gligli/p600fw/documentation/pictures/4b_solder_wires.jpg

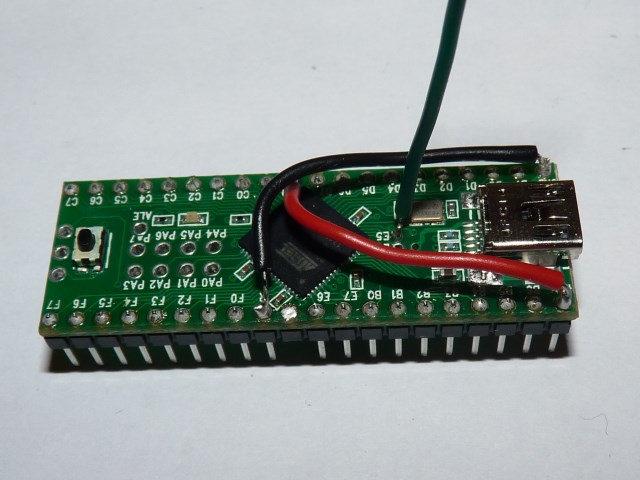
documentation/pictures/4b_solder_wires.jpg
