gligli/p600fw/documentation/pictures/2_solder_wires.jpg

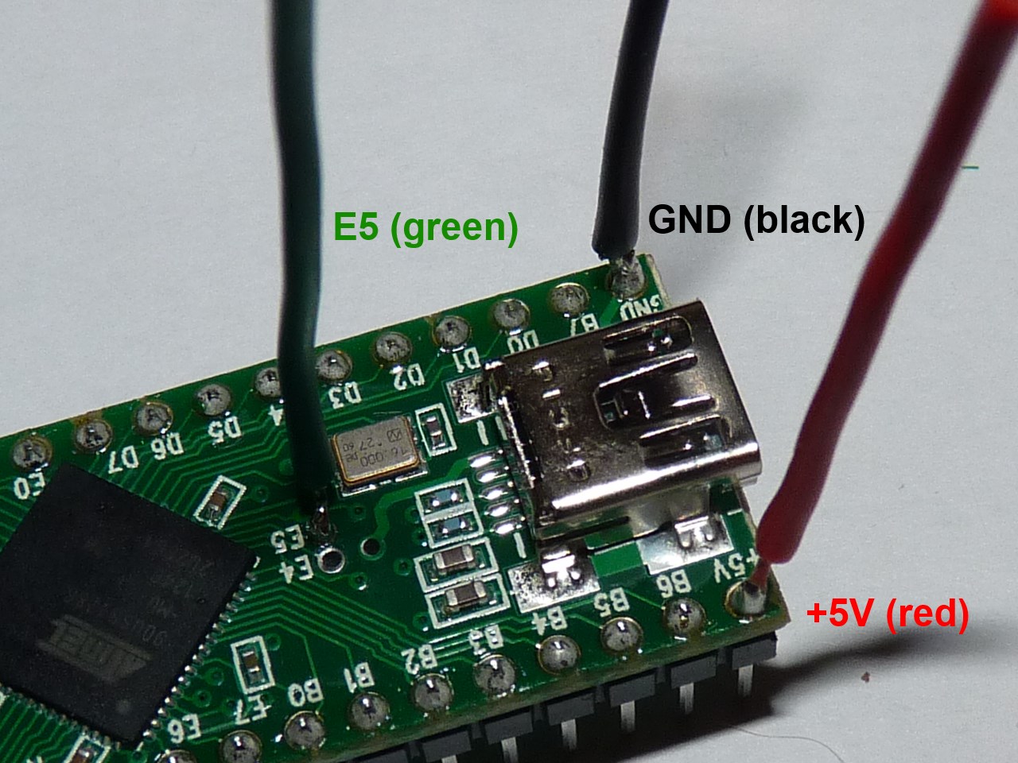
documentation/pictures/2_solder_wires.jpg
