gligli/p600fw/documentation/latex/pitchbend.tex

The Prophet-600 comes with a (pitch) \textbf{Bender} (without automatic return to the middle position). With the upgrade it is possible to customize the range/action and the target of the bender as part of the patch configuration (see below). 

Note: External MIDI pitch bend is \underline{added} to the internal pitch bend\footnote{This is the behaviour of the original firmware. Since the bender does not return to zero a bend override by external MIDI leads to unwanted discontinuous pitch changes when the bender of the Prophet-600 is touched. The addition of both bends is therefore more consistent.}. Full internal and external (MIDI) bend covers twice the range set by the bender range. As a consequence, the external MIDI bend value cannot be reset/overridden using the built in bender, but the external value is reverted to zero during the bender calibration process (see below).

\begin{itemize}
  \item The bender can target the oscillator pitch, the filter cut-off frequency or the amplitude. This is set using the additional patch parameter \bentarget which provides the options \textit{off}, \textit{AB} (bend of the pitch of both oscillators), \textit{VCF} (modulating the cut-off frequency), \textit{volume} (modulating the amplitude) and \textit{b} (bending the pitch of oscillator B only).
  \item The range of the bender can be configured using the additional patch parameter \bendrange. It offers the choices \textit{2nd} (bend a full tone), \textit{3rd} (bend 4 semi-tones), \textit{5th} (bend 7 semi-tones) and \textit{octave} (bending an entire octave).
\end{itemize}

The upgraded Prophet-600 also offers the option to calibrate the bender middle position using one of the miscellaneous settings/function (see section \ref{settingsref}). This function is useful to remove jittery behaviour of the bender around the middle position. In order to calibrate the bender follow the steps below.

\begin{enumerate}
  \item Move the bender to the middle position.  
  \item Activate bender calibration by pressing \numberbut{3} in \shiftmode or \shiftlock (the display will show that the bender calibration mode is active). Pressing \numberbut{3} again applies and confirms the calibration and exits the calibration mode.
\end{enumerate}

As mentioned above, the current active external (MIDI) bend value is set to zero during the calibration process. To be precise, it is set to zero with the first press of \numberbut{3} in \shiftmode or \shiftlock.
