gligli/p600fw/documentation/latex/envelopes.tex

Like the original version, the upgraded Prophet-600 offers two ADSR envelopes. The first one is the filter envelope, which modulates the filter cut-off frequency. Its parameters are located in the filter section of the panel, see section \ref{filter}. The second envelope has a dedicated sub-panel below the filter section\footnote{In the original Prophet-600 as well as in the upgrade up to version 2.1 RC3 the 2nd envelope is a dedicated amplitude envelope and on the original panel and on the existing panel overlays the sub-panel is marked "Amplifier". With the envelope routing option in the latest firmware version the envelope and its sub-panel are more appropriately called "2nd Envelope" in this document.}.

Both envelopes work identically in that they have a classic ADSR setup with an \attack control, a \decay control, a \sustain control and a \release control. 

\begin{center}
\scalebox{0.4}{
  \begin{tikzpicture}[scale=0.8]

    \addpar{-18cm,3.5cm}{\secndenv \\ This modifies the overall shape and speed range of the second envelope. It influences the attack, decay and release phases of the envelope};
    \draw[line width = 2pt, dashed] (-4cm,3.5cm) -- (1cm,3.5cm);

      \adsrpanel{0,0}
  \end{tikzpicture}
}
\end{center}

The upgraded Prophet 600 provides faster and smoother envelopes, with two different envelope time scales (\textit{slow} and \textit{fast}) and two envelope shapes (\textit{linear} and \textit{exponential})

You can set the shape and speed range independently for the filter and the 2nd envelope using two additional patch parameters. The parameter \secndenv changes the 2nd envelope and the parameter \filenv changes the filter envelope. Each of the two parameters can take the following values:

\begin{itemize}
  \setlength\itemsep{0cm}
  \item \textit{linear - slow}
  \item \textit{exponential - slow}
  \item \textit{linear - fast}
  \item \textit{exponential - fast}
\end{itemize}
 
 The envelope shapes are shown below. The \textit{linear} shape is strictly linear in the entire attack phase and in the main attenuation phases of decay and release, but it tails out exponentially. \footnote{Up to version 2.1 RC3 the linear envelope shape was strictly linear in the decay and release without a soft tail. The new shape sounds more organic as it does not drop hard to zero. It was inspired by the Prophet-5 rev 1/2 envelope behaviour.} 
 
 \scalebox{0.6}{
  \begin{tikzpicture}[scale=0.8]
    \envelopeexp{0,0}{6}{4}{5}{8}{6}

\end{tikzpicture}
  }

The phase durations of the ADSR envelopes range between $<30 ms$ to $>50 s$.

\textbf{Envelope modulation targets}
 
The envelopes have three available targets: filter cut-off frequency, amplitude and poly-mod (for this see section \ref{polymod}). The filter envelope is always routed to the filter cut-off frequency and the modulation strength is controlled by the \filenv control. For the  amplitude and poly-mod targets, different routing options are provided as described in detail in the section on poly-mod \ref{polymod}. The additional patch parameter \envrouting is used to configure which envelope modulates which target. The main benefit from the routing options is to make poly-mod independent from the filter dynamics. The default routing is that the poly-mod is modulated by the filter envelope and the amplitude is modulated by the 2nd envelope. This is the original routing and the routing of versions 2.0 and 2.1 RC3. 

The modulation strength of the amplitude is fixed and positive in the Prophet-600. The modulation strength of the poly-mod is set by the bipolar \polymodenv control as explained in section \ref{polymod}.
