gligli/p600fw/documentation/latex/patchref.tex

\footnotesize
\renewcommand{\arraystretch}{1.3}
\begin{tabular}{ p{1.5cm}|p{3cm}|p{5cm}|p{5cm}|p{4cm}} 
   Number & Group & \makebox{1st press} & \makebox{2nd press} & \makebox{3rd press}\\ \hline
  0 & Speed & \makebox{Seq/Arp Speed} \linebreak \textit{numeric 0...99} & &  \\ \hline
  1 & LFO & \makebox{LFO Shape} \linebreak \textit{tri-pulse, sin-random, saw-noise} & \makebox{LFO Target} \linebreak \textit{A\&B, A, B, A \& B \& VCA } &  \makebox{LFO Clock Sync} \linebreak \textit{off, key, 1, 2, 3, 4, 5, 6, 8} \\ \hline
  2 & \makebox{Vibrato} & \makebox{Vibrato Speed} \linebreak \textit{numeric 0...99} & \makebox{Vibrato Amount} \linebreak \textit{numeric 0...99} & \makebox{Vibrato Target} \linebreak \textit{VCO, VCA, VCO A, VCO B} \\   \hline
  3 & \makebox{Modulation Wheel} & \makebox{Modulation Wheeel Target} \linebreak \textit{LFO, vibrato} & \makebox{Modulation Delay} \linebreak \textit{numeric 0...99} & \makebox{Moduation Wheel Range} \linebreak \textit{touch, soft, high, full} \\ \hline
  4 & \makebox{Configuration} & \makebox{OSC Pitch Mode} \linebreak \textit{free, semi-tones, octaves} & \makebox{External Voltage} \linebreak \textit{numeric 0...99} & \makebox{Pulse Reset Bug} \linebreak \textit{on, off} \\ \hline
  5 & Envelope & \makebox{Filter Envelope Shape} \linebreak \textit{lin-slow, lin-fast, lin-slo, exp-fast}  & \makebox{2nd Envelope Shape} \linebreak \textit{fast-lin, fast-exp, slo-lin, slo-exp} &
  \makebox{Envelope Routing} \linebreak \textit{std, poly-amp, poly, gate}\\ \hline
  6 & Bender & \makebox{Bender Target} \linebreak \textit{off, AB, VCO, VCF, vol, B} & \makebox{Bend Range}  \linebreak \textit{2nd, 3rd, 5th, octave} &  \\ \hline
  7 & \makebox{Play Mode} & \makebox{Note Priority} \linebreak \textit{last, low, high} & \makebox{Voice Assigner} \linebreak \textit{first, cycle} & Glide\textsuperscript{*)} \linebreak \textit{numeric 0...99}  \\ \hline
  8 & \makebox{Oscillator} & Detune \linebreak \textit{numeric 0...99}  &   \makebox{Vintage (Spread)} \linebreak \textit{numeric 0...99} & Drive\textsuperscript{*)} \linebreak \textit{numeric 0...99} \\ \hline
  9 & \makebox{Touch Sensitivity} & \makebox{Amplitude Velocity} \linebreak \textit{numeric 0...99}  & \makebox{Filter Velocity} \linebreak \textit{numeric 0...99} &  \\
  
\end{tabular}

\normalsize

\textsuperscript{*)} The availability of parameters \glide and \drive depend on the panel layout. In \textit{GliGli} panel layout \glide is available and drive is obsolete. In \textit{SCI} layout the parameter \drive is available while the glide parameter is set using the dedicated dial on the panel.
