gligli/p600fw/documentation/latex/filter.tex

The mix of the two VCOs is routed through a resonant 24db low pass filter (built on a Curtis CEM3372 filter). The control for the filter consists of a \filtercutoff dial regulating the cut-off frequency, and a \filterres dial for the resonance. The \filterenv dial regulates how strongly the cut-off frequency is modulated by the filter envelope. This dial is bipolar. It supports positive and negatives values (effectively an inverse envelope setting). The display will show values between -50 and 50 depending on position. This is major enhancement compared to the original Prophet-600 firmware which  featured only positive values.

\begin{center}
\scalebox{0.4}{
  \begin{tikzpicture}[scale=0.8]
    \addpar{-18cm,9.8cm}{\textbf{Filter Limit} \\ Using the miscellaneous setting options the cut-off frequency can be limited to 22kHz, see section \ref{limitsett} for details.};
    \draw[line width = 2pt, dashed] (-4cm,9.3cm) -- (1cm,9.3cm);

    \addpar{-18cm,2cm}{\textbf{\filenv} \\ This modifies the overall shape and speed range of the envelope. It influences the attack, decay and release phases, see \ref{envelopes} for details};
    \draw[line width = 2pt, dashed] (-4cm,3.5cm) -- (1cm,3.5cm);

    \filterpanel{0,0}
  \end{tikzpicture}
}
\end{center}

The \keyboardtrack switch has the setting \textit{Off}, \textit{1/2} and \textit{Full}. It lifts the cut-off frequency depending on keyboard note, i.e. the cut-off frequency is higher for higher notes. The effect applies to the cut-off frequency resulting from the fixed \filtercutoff setting plus any envelope and LFO modulation.  

\textbf{Equal tempered tuning of the filter cut-off frequency}

In the Prophet-600 the filter cut-off frequency is tuned in the same manner as the oscillator frequencies. Furthermore \keyboardtrack is implemented in a way to allow equal tempered play using the filter:

\begin{itemize}
  \item When \keyboardtrack is set to \textit{half} then the filter cut-off is increased by a semitone every two semitones on the keyboard 
  \item When \keyboardtrack is set to \textit{full} then the filter cut-off is increased by a semitone with every semitone on the keyboard, i.e. if follows the scale 
\end{itemize}

This feature essentially provides a third oscillator per voice. You can play harmonically using the filter at self-resonance even without oscillator A or B active - you should set the \filterenv dial to zero, at least in first experiments. The \filtercutoff acts as a tuning dial in this case. You can also use the self-resonant filter in combination with oscillators A and B if you "tune" the filter frequency appropriately. You can even use cross-modulation using the poly-mod function to modulate the filter cut-off using oscillator B (see section \ref{polymod}). However, there is no way to control the volume of the filter self-resonance relative to the volume of oscillators A and B.
