gligli/p600fw/documentation/latex/defaultpatch.tex

When powered up, the Prophet-600 starts either in \presetmode (with the last selected patch loaded) or in \livemode. In either mode the user can load a default setup to start a new patch. To load the default patch press the \preset button twice in \shiftmode or \shiftlock (upon first press the display shows that another press will load the default patch). When the default patch is loaded, the Prophet-600 automatically switches to \presetpanel. Note that loading  the default patch overwrites the patch menu parameters and therefore any unsaved patch parameter values in \presetmode are lost.

The default patch is intended to be a very basic/minimal setup. The values are shown in the table below.

\footnotesize
\renewcommand{\arraystretch}{1.3}

\begin{longtable}[l]{p{5cm}|p{5cm}|p{5cm}|p{5cm}|} 
\textbf{Continuous Parameter} & \textbf{Value} & \textbf{Stepped Parameter} & \textbf{Value} \\ \hline
\endfirsthead
\textbf{Continuous Parameter} & \textbf{Value} & \textbf{Stepped Parameter} & \textbf{Value} \\ \hline
\endhead 
Osc A Frequency & \textit{c0} & Osc A Saw & \textit{on} \\ \hline
Osc A Volume & \textit{full} & Osc A Triangle &\textit{off} \\ \hline
Osc A Pulse Width & \textit{half} & Osc A Square & \textit{off} \\ \hline
Osc B Frequency & \textit{c0} & Osc B Saw & \textit{off} \\ \hline
Osc B Volume & \textit{zero} & Osc B Triangle & \textit{off} \\ \hline
Osc B Pulse Width & \textit{half} & Osc B Sqr &\textit{off} \\ \hline
Osc B Fine & \textit{zero} & Sync & \textit{off} \\ \hline
Cutoff & \textit{full} & Poly Mod Oscillator A Destination & \textit{off} \\ \hline
Resonance & \textit{zero} & Poly Mod Filter Destination & \textit{off} \\ \hline
Filter Envelope Amount & \textit{zero} & LFO Shape & \textit{triangle-pulse} \\ \hline
Filter Release & \textit{zero} & LFO Sync & \textit{off} \\ \hline
Filter Sustain & \textit{zero} & LFO Targets & \textit{A \& B} \\ \hline
Filter Decay & \textit{zero} & Keyboard Filter Tracking & \textit{off} \\ \hline
Filter Attack & \textit{zero} & Filter Envelope Shape & \textit{linear} \\ \hline
Amp Release & \textit{zero} & Filter Envelope Fast/Slow & \textit{slow} \\ \hline
Amp Sustain & \textit{full} & 2nd Envelope Shape & \textit{linear} \\ \hline
Amp Decay & \textit{zero} & Unison & \textit{off} \\ \hline
Amp Attack & \textit{zero} & Assigner Priority Mode & \textit{last} \\ \hline
Poly Mod Filter Amount & \textit{zero} & Bender Range (semitones) & \textit{5 semitones} \\ \hline
Poly Mod Osc B Amount & \textit{zero} & Bender Target & \textit{pitch A \& B} \\ \hline
LFO Frequency & \textit{mid} & Mod Wheel Range & \textit{soft} \\ \hline
LFO Amount & \textit{zero} & Osc pitch mode & \textit{octave-octave} \\ \hline
Glide & \textit{zero} & Mod Wheel Target & \textit{LFO} \\ \hline
Amp Velocity & \textit{mid} & Vibrato Target & \textit{pitch} \\ \hline
Filter Velocity & \textit{zero} & 2nd Envelope Fast/Slow & \textit{slow} \\ \hline
Modulation delay & \textit{zero} & Sync Bug & \textit{off} \\ \hline
Vibrato frequency & \textit{mid} & Voice Assign & \textit{first} \\ \hline
Vibrato amount & \textit{zero} & Envelope Routing & \textit{standard} \\ \hline
Unison detune & \textit{zero} & &  \\ \hline
External CV amount & \textit{zero} &  &  \\ \hline
Vintage / Spread & \textit{zero} &  &  \\ \hline 
\end{longtable}
