gligli/p600fw/documentation/latex/settingsref.tex

\footnotesize
\renewcommand{\arraystretch}{1.6}
\begin{tabular}{ p{2cm}|p{4cm}|p{6cm}|p{6cm}} 
   \textbf{Number} & \textbf{Purpose} & \makebox{\textbf{1st press}} & \makebox{\textbf{Repeated press}} \\
 \hline
  0 & \makebox{MIDI mode} & \makebox{Show current selected voice status} & \makebox{Toggle MIDI mode} \linebreak \textit{local on, local off}  \\
 \hline
  1 & \makebox{MIDI Receive} & \makebox{Show current MIDI receive channel} & \makebox{Cycle through channels} \linebreak \textit{OMNI, Ch1 ... Ch16} \\
 \hline
  2 & \makebox{MIDI Send} & \makebox{Show current MIDI send channel} & \makebox{Cycle through channels} \linebreak \textit{Ch1 ... Ch16} \\
 \hline
  3 & \makebox{Bender Calibration} & \makebox{Activate calibration mode} & \makebox{Confirmation} \\
 \hline
  4 & \makebox{Voice Selection} & \makebox{Show current selected voice} & \makebox{Cycle through voices} \linebreak \textit{1 ... 6} \\
 \hline
  5 & \makebox{Voice Deactivate} & \makebox{Show current selected voice status} & \makebox{Toggle voice status} \linebreak \textit{on, off} \\
 \hline
  6 & \makebox{Panel Layout} & \makebox{Show current selected panel layout} & \makebox{Toggle panel layout} \linebreak \textit{GliGli, SCI} \\
 \hline
  7 & \makebox{Unused} & & \\
 \hline
  8 & \makebox{Clock Sync} & \makebox{Show current clock sync} & \makebox{Cycle through sync types} \linebreak \textit{internal, MIDI, tape}  \\
 \hline
  9 & \makebox{VCF limit} & \makebox{Show current setting} & \makebox{Cycle through settings} \linebreak \textit{on, off}  \\
 \hline
  Preset & \makebox{Default Patch} & \makebox{Activate default patch load} & \makebox{Confirmation} \\
 \hline
  Tune & \makebox{Per Note Tuning} & \makebox{Activate per note tuning} & \makebox{Deactivate/save per note tuning} \\
 \hline
  Record & \makebox{MIDI Patch Receive Mode} & \makebox{Activate MIDI patch receive mode} & \makebox{End MIDI patch receive mode} \\
  \end{tabular}
\normalsize
