gligli/p600fw/documentation/latex/p600fw_Cheat_Sheet.tex

\documentclass{report}
\usepackage{lmodern}
\usepackage{hyperref}
\usepackage{titlesec}
\usepackage{scrextend}
\usepackage{array}
\usepackage{ProphetPanel}
\usepackage{fontspec}
\usepackage[T1]{fontenc}
\usepackage{float}
\usepackage[paperheight=7.1cm,paperwidth=6.1cm,margin=5pt,heightrounded]{geometry}

\begin{document}

  \scalebox{0.7}{
    \begin{tikzpicture}[scale=0.8]
      \numberpadcc{-10cm,0cm}
    \end{tikzpicture}
  }

\end{document}
