gligli/p600fw/documentation/pictures/1_cut_5v.jpg

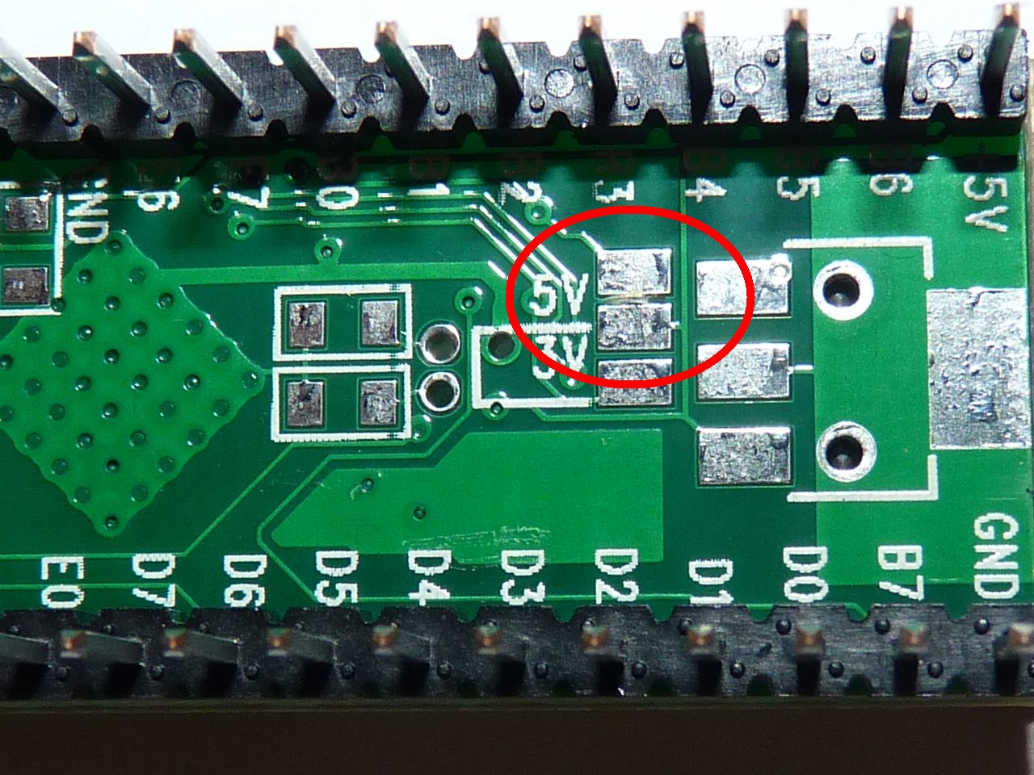
documentation/pictures/1_cut_5v.jpg
