gligli/p600fw/documentation/pictures/3_cut_pin.jpg

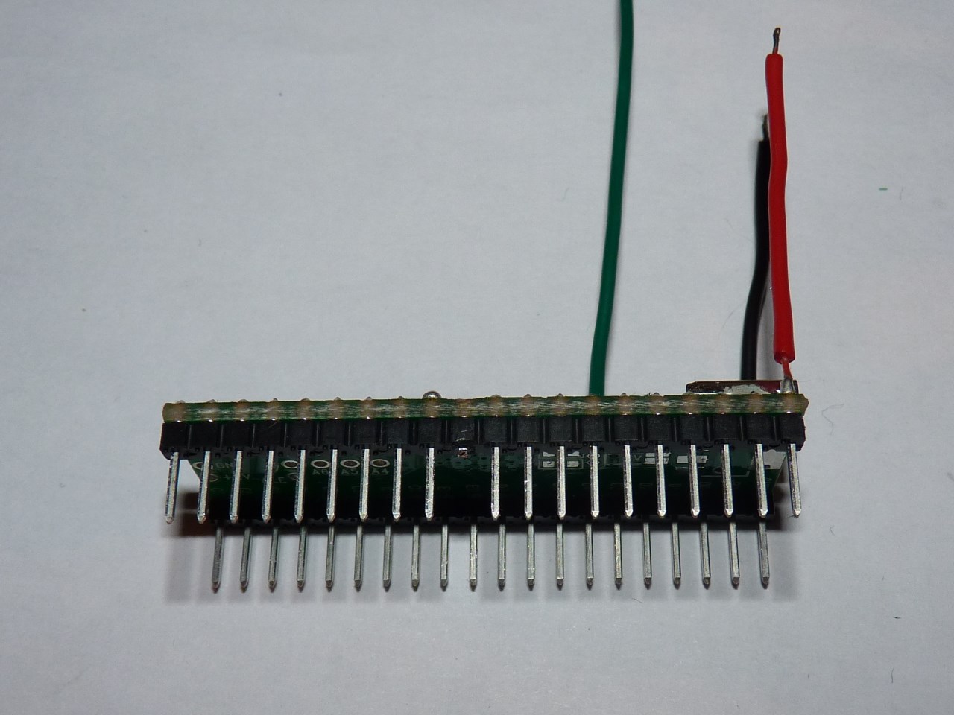
documentation/pictures/3_cut_pin.jpg
