gligli/p600fw/documentation/pictures/5_plug_wire.jpg

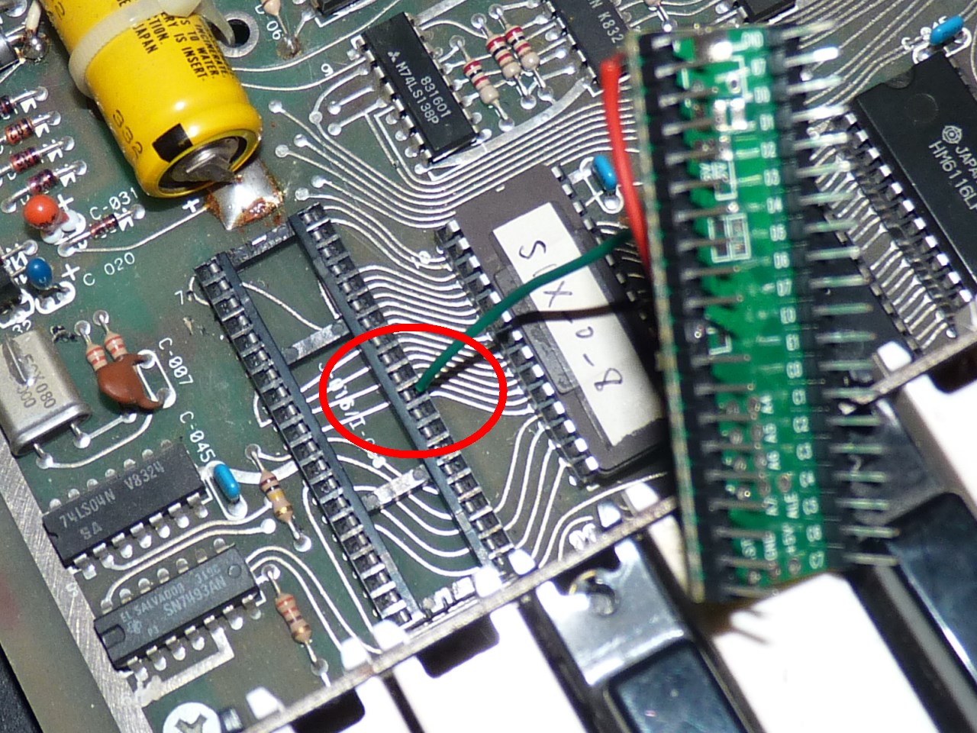
documentation/pictures/5_plug_wire.jpg
