gligli/p600fw/documentation/pictures/6_plug_teensy.jpg

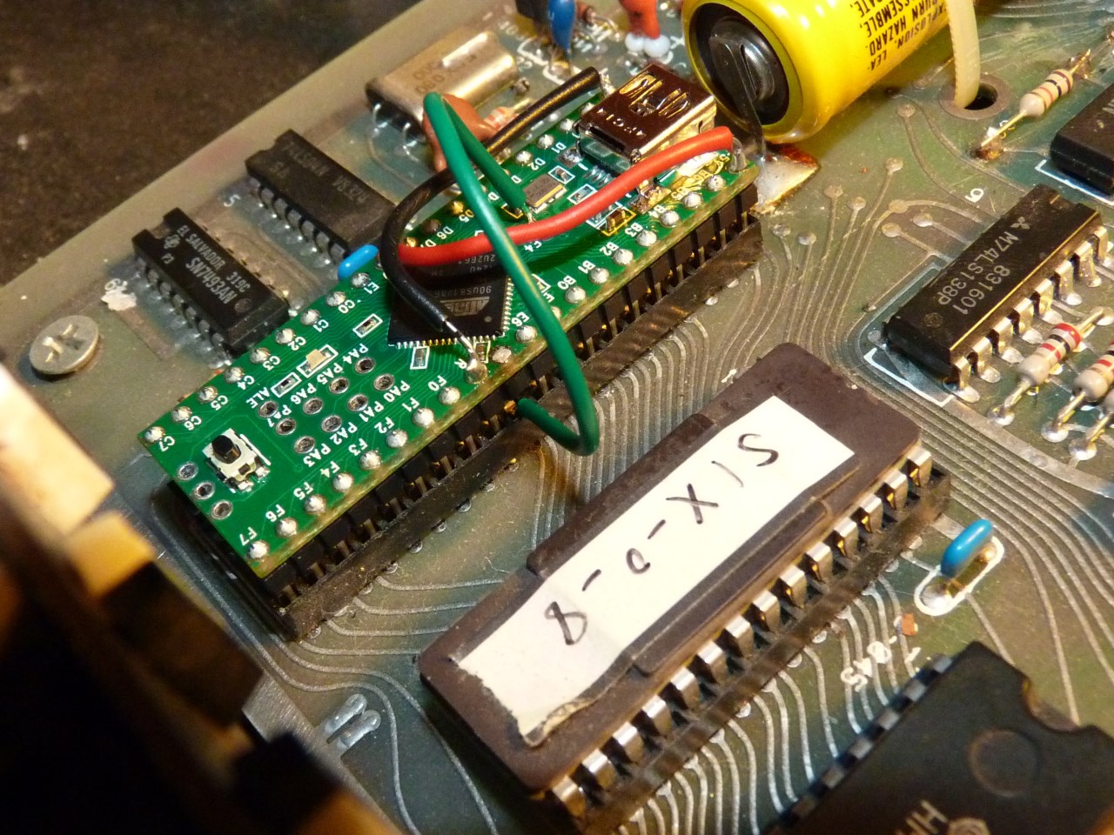
documentation/pictures/6_plug_teensy.jpg
