gligli/p600fw/documentation/pictures/external_24LC512_EEPROM/20251117_125559.jpg

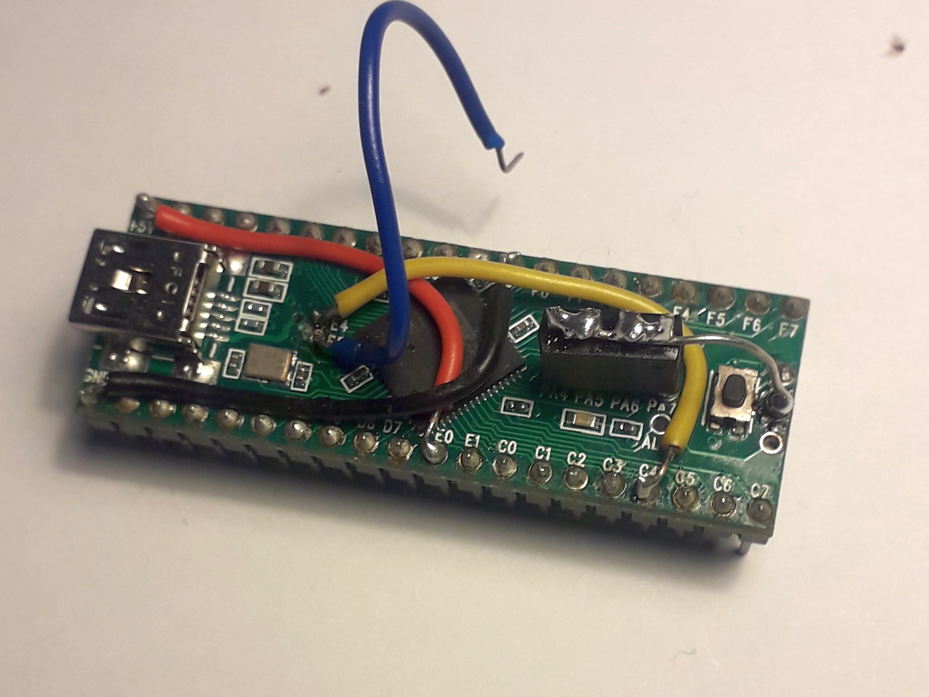
documentation/pictures/external_24LC512_EEPROM/20251117_125559.jpg
