gligli/p600fw/documentation/sysex_format.ods

Overall SYSEX patch dump request format
Bit count | Value | Description
8 | 0xF0 | SYSEX header
24 | 0x00 0x61 0x16 | My vendor identifier
8 | 0x02 | Command code, “Patch dump request” here
8 | 0-99 | Patch number
8 | 0xF7 | SYSEX footer
Overall SYSEX patch dump format
Bit count | Value | Description
8 | 0xF0 | SYSEX header
24 | 0x00 0x61 0x16 | My vendor identifier
8 | 0x01 | Command code, “Patch dump” here
variable | variable | Encoded raw patch data, truncated to the last nonzero byte
8 | 0xF7 | SYSEX footer
Encoded data format (repeats every 32 bits of raw data)
Bit count | Value | Description
1 | 0 | Padding
7 | variable | Bits 30-24 of raw data (MSB first)
1 | 0 | Padding
7 | variable | Bits 22-16 of raw data (MSB first)
1 | 0 | Padding
7 | variable | Bits 14-8 of raw data (MSB first)
1 | 0 | Padding
7 | variable | Bits 6-0 of raw data (MSB first)
4 | 0 | Padding
1 | variable | Bit 7 of raw data
1 | variable | Bit 15 of raw data
1 | variable | Bit 23 of raw data
1 | variable | Bit 31 of raw data
Raw patch data format
Bit count | Value | Description
8 | 0-99 | Patch number
32 | 0xA5 0x16 0x61 0x00 | My patch format identifier
8 | 0x02 | My patch format version
16 | unsigned, little endian order | Osc A Frequency
16 | unsigned, little endian order | Osc A Volume
16 | unsigned, little endian order | Osc A Pulse Width
16 | unsigned, little endian order | Osc B Frequency
16 | unsigned, little endian order | Osc B Volume
16 | unsigned, little endian order | Osc B Pulse Width
16 | unsigned, centered on half scale, little endian order | Osc B Fine
16 | unsigned, little endian order | Cutoff
16 | unsigned, little endian order | Resonance
16 | unsigned, centered on half scale, little endian order | Filter Envelope Amount
16 | unsigned, little endian order | Filter Release
16 | unsigned, little endian order | Filter Sustain
16 | unsigned, little endian order | Filter Decay
16 | unsigned, little endian order | Filter Attack
16 | unsigned, little endian order | Amp Release
16 | unsigned, little endian order | Amp Sustain
16 | unsigned, little endian order | Amp Decay
16 | unsigned, little endian order | Amp Attack
16 | unsigned, centered on half scale, little endian order | Poly Mod Filter Amount
16 | unsigned, little endian order | Poly Mod Osc B Amount
16 | unsigned, little endian order | LFO Frequency
16 | unsigned, little endian order | LFO Amount
16 | unsigned, little endian order | Glide
16 | unsigned, little endian order | Amp Velocity
16 | unsigned, little endian order | Filter Velocity
7 | 0 | Padding
1 | bit (Off=0,On=1) | Osc A Saw
7 | 0 | Padding
1 | bit | Osc A Triangle
7 | 0 | Padding
1 | bit | Osc A Square
7 | 0 | Padding
1 | bit | Osc B Saw
7 | 0 | Padding
1 | bit | Osc B Triangle
7 | 0 | Padding
1 | bit | Osc B Sqr
7 | 0 | Padding
1 | bit | Sync
7 | 0 | Padding
1 | bit | Poly Mod Oscillator A Destination
7 | 0 | Padding
1 | bit | Poly Mod Filter Destination
5 | 0 | Padding
3 | Pulse=0,Tri=1,Rand=2,Sine=3,Noise=4,Saw=5 | LFO Shape
7 | 0 | Padding
1 | Low=0,High=1 | LFO Speed Range
2 | 0 | Padding
6 | None=0,VCO=1,VCF=2,VCA=4,PW=8,OnlyA=16,OnlyB=32 (combination of those) | LFO Mode Destination
6 | 0 | Padding
2 | None=0,Half=1,Full=2 | Keyboard Filter Tracking
7 | 0 | Padding
1 | Linear=0,Exponential=1 | Filter EG Exponential/Linear
7 | 0 | Padding
1 | Fast=0,Slow=1 | Filter EG Fast/Slow
7 | 0 | Padding
1 | Linear=0,Exponential=1 | Amp EG Exponential/Linear
7 | 0 | Padding
1 | Fast=0,Slow=1 | Amp EG Fast/Slow
7 | 0 | Padding
1 | bit | Unison
6 | 0 | Padding
2 | Last=0,Low=1,High=2 | Assigner Priority Mode
4 | 0 | Padding
4 | 2nd=2,3rd=5,5th=7,Octave=12 | Pitch bender semitones
6 | 0 | Padding
2 | Off=0,VCO=1,VCF=2,Volume=3 | Pitch bender target
5 | 0 | Padding
3 | Min=5,Low=3,High=1,Full=0 | Modulation wheel range
6 | 0 | Padding
2 | Free=0,Semitone=1,Octave=2 | Osc pitch mode
16 | unsigned, little endian order | Modulation delay
16 | unsigned, little endian order | Vibrato frequency
16 | unsigned, little endian order | Vibrato amount
16 | unsigned, little endian order | Unison detune
16 | unsigned, little endian order | Arpeggiator/sequencer clock
7 | 0 | Padding
1 | LFO=0,Vibrato=1 | Modulation wheel target
8 | 0 | Padding
6*8 | 6 offsets in semitones to the lowest chord note, 0xFF padded. Eg: 6 times 0x00 for unison, 0x00 plus 5 times 0xFF for mono mode. | Unison track pattern
