gligli/p600fw/documentation/Prophet600_User_Manual.odt

GliGli’s Sequential Circuits Prophet 600 Firmware Upgrade

Table of Contents

###### User Manual / Getting Around the New Prophet 600

###### Review of New Features

The Prophet 600 Firmware Upgrade hosts the following improvements:

1. Easy-to-install non-destructive firmware drop-in replacement of the new firmware. If you ever find yourself pining for the old sound of your Prophet 600, you can remove the Teensy and restore the Z80.
2. Greater resolution of many of the sound parameters with an improved refresh rate that is making the instrument much more responsive.
3. Faster, smoother amplifier and filter envelope generators supporting four different modes:
  1. Fast Linear.
  2. Slow Linear.
  3. Fast Exponential.
  4. Slow Exponential.
4. A new LFO function generator with a wider range from one cycle every <20 seconds> to about 60Hz with four new waveforms in addition to the original triangle and square including sine, random stepped, noise (like on the original Prophet 5, but non-periodic) and sawtooth (ramp up).
5. A dedicated vibrato which can be controlled by the modulation wheel, or can start progressively after a fixed amount of time.
6. Multiple keyboard modes including last/low/high note priority.
7. Unison detune.
8. Mix Overdrive which now allows the output from both oscillators to drive the mix VCAs A and B harder as well as the Curtis 4 pole filter resulting in new sonic possibilities.
9. Pitch Wheel interval selection of plus/minus one octave, a whole tone, a minor third and a fifth.
10. Pitch Wheel reassignment to the VCF and Volume or off.
11. Modulation wheel intensity setting from Maximum to Medium to Minimum.
12. Full Midi In control including:
  1. Amp and Filter velocity sensitivity with an external keyboard controller.
  2. Continuous Controllers (CC) of all sound parameters.
  3. Program change (PC) to choose current preset.
  4. Synchronizing the arpeggiator to MIDI clock.
13. A new and improved tuning procedure.
14. Octave, chromatic and free Oscillator course pitch control.
15. Plus/Minus setting for Oscillator Fine Tune and Filter Envelope amount for Poly Mod and Filter.
16. Assignable, Random And Up/Down Arpeggiator.
17. Debounce feature that prevents unintended retriggering caused by the old keyboard.
18. Organised open source code available on GitHub: https (https://github.com/gligli/p600fw):// (https://github.com/gligli/p600fw)github (https://github.com/gligli/p600fw). (https://github.com/gligli/p600fw)com (https://github.com/gligli/p600fw)/ (https://github.com/gligli/p600fw)gligli (https://github.com/gligli/p600fw)/ (https://github.com/gligli/p600fw)p (https://github.com/gligli/p600fw)600 (https://github.com/gligli/p600fw)fw (https://github.com/gligli/p600fw)

###### Settings Pages

The Prophet 600 is now organised around two menu pages through which you configure the instrument.

1. The Additional Parameters Page is the default page in manual mode, and is active when pressing “to tape” in preset mode: This is the normal interaction page. The advanced sound parameters are found here such as selecting new LFO waveforms, envelope generator profiles and ranges of various controllers.
2. A Miscellaneous Settings Page active when “from tape” is kept pressed: This is the page used to access various “housekeeping” parameters such as setting MIDI channels and modes and so on.

###### Tune

Upon first power-up, the Prophet 600 tunes itself. The “Tune” light illuminates and the display indicates the oscillator or filter being tuned from A1 through A6, b1 through b6 and F1 through F6 for Oscillator A, B and the Filter respectively. The routine takes about 20 seconds to complete depending on the tuning of your instrument.

It is normal to have to retune the instrument during the first 30 minutes of operation as the electronics warm to a stable operating temperature. To tune, simply press the tuning button as required.

###### Manual/Preset Modes

As with the original Prophet 600 firmware, pressing the Preset button switches between manual mode, in which the synthesiser parameters sound parameters reflect the active sonic-state of the instrument, and preset mode in which the sound is a stored patch.

You can edit a stored patch or manual patch or preset patch at any time by completing the following:

1. Press the “Record” button on the keypad. It will blink.
2. Press the two digit location to which you want to save the patch.

The patch is saved. It will overwrite whatever sound patch was there before.

You can cancel a patch store any time while the “Record” button is blinking by pressing record.

###### Additional Parameters Page Quick Guide

Below is a table summarising the Parameters and keypad buttons required to access the synthesiser additional parameters. More detailed instructions are provided after the table summary.

To select a parameter, press one of the keypad numbers once or twice, its name and value will be displayed. To edit it, used the “Speed” knob.

###### Miscellaneous Settings Page Quick Guide

Below is a table summarising the keypad buttons required to access the synthesiser miscellaneous settings. More detailed instructions are provided after the table summary.

To access a function, maintain “from tape” pressed and press a keypad number.

###### Arpeggiator

The instrument supports three arpeggiator modes:

1. Arp Down/Up plays an up/down note sequence with double trigger on the lowest and highest note. For example, playing C3 C4 E4 G4 will play: C3 C4 E4 G4 G4 E4 C4 C3 C3 C4 and so on. Mathematically, it allows you to work out the time signature. Three notes results in ¾ time, notes 4/4 time, 5 notes in 5/4, etc. To play with the Arp Up/Down, press the Arp Dn/Up button on the keypad. The “Arp Dn/Up” will light continuously.
2. Arp Assignable sequences the notes in the order that they are played. To play with the Arp Assignable, press the “Arp Assign” button and play the notes in the order you want them sequenced. The “Arp Assign” will light continuously.
3. Arp Random plays notes played in a random order. To play the Arp Random, press the “Arp Assign” button twice until it blinks and then play the notes.

With all Arpeggiator modes, press the “Record” button on the keypad to latch or hold the notes played. Playing additional notes while in Record mode will latch addition notes to the existing sequence to a maximum of 128 notes. To clear the notes from the sequence, press the “Record” button to switch it off.

The speed is controlled by pressing “0” once on the additional parameters page and using the “Speed” knob to change it.

The foot switch input can be used to hold the arpeggiator.

###### Keyboard Modes

The Prophet 600 can be either in Polyphonic, Unison or Chord mode.

1. The synthesizer starts in Polyphonic mode, in which any new note will be assigned to one of the 6 voices.
2. If you switch “Unison track” on with no pressed key, you are in Unison mode, all 6 voices will play the same note.
3. If you switch “Unison track” on with one or more pressed keys, you are in Chord mode. The pattern those keys made will now be transposed over the whole keyboard range by new notes.

The foot switch input can be used to latch a new pattern of notes.

New notes will be assigned to voices using one of those priority rules:

1. “Last”: New notes will always play, the oldest notes may be stolen.
2. “Low”: Only the lowest notes will play. In Unison or Chord mode, legato will be active.
3. “High”: Only the highest notes will play. In Unison or Chord mode, legato will be active.

The assignment priority is controlled by pressing “7” twice on the additional parameters page and using the “Speed” knob to change it.

###### New Behaviour for Knobs

###### Value Display

When you turn any knob, its value will now be shown on the 7-segment display.

That value will always go from 0 to 255. The display being only 2 digits, the decimal dot is used to show hundreds (no dot for 0-99, steady dot for 100-199, blinking dot for 200-255).

The knob true resolution can be greater than 0-255 (8bits) to ensure smooth sound changes.

###### Oscillator A and B Mix

A new feature has been introduced that allows the VCAs into the filter to be over-driven by Oscillator A and B. In order to support this, the Oscillator A/B Mix has been reassigned to the Oscillator A Level and the Glide knob now controls the Oscillator B Level. The normalised point is at about half way or 5 on the dial. To overdrive the inputs, go all the way to 10. Because of this, the Glide speed has been reassigned to the “Glide” additional parameter (press “7” once on the additional parameters page).

Negative Values

The Poly Mod Filter Amount, the Filter Amount and the Detune knobs are now zero set to the midway position to allow both positive and negative values. This means that inverse envelopes can be applied to the modulations and filter controls and it is now possible to detune Oscillator B flat as well as sharp with respect to Oscillator A.

###### Low Frequency Oscillator

###### LFO Waveform

The Prophet 600 now supports six waveforms in addition to the standard Triangle and Square waves including Sine, (Saw) Ramp Up, Random, Noise. To select the desired waveform:

1. For Triangle, Sine or Saw:
  1. If you are in preset mode, make sure “to tape” is lit, else press it to access the additional parameters page.
  2. Switch the LFO-MOD Shape button to Triangle.
  3. Press the “1” button once and use the “Speed” knob to select the Triangle, Sine or Saw. The display indicates the current selection.
1. For Square, Random or Noise:
  1. If you are in preset mode, make sure “to tape” is lit, else press it to access the additional parameters page.
  2. Switch the LFO-MOD Shape button to Square.
  3. Press the “1” button once and use the “Speed” knob to select the Square, Random or Noise. The display indicates the current selection.

###### LFO Speed

You can control the speed range of the LFO from Slow; the default setting; to Fast by pressing “1” once on the additional parameters page and using the “Speed” knob to select either Slow of Fast.

LFO Target

You can choose to assign the LFO to only one of the two oscillators by pressing “1” twice on the additional parameters page and using the “Speed” knob to select either Oscillator A, Oscillator B or both as a target.

Vibrato

The Prophet 600 now features a dedicated pitch vibrato. You can adjust its speed by pressing “2” once and its amount by pressing “3” once on the additional parameters page.

By default, it is controlled by a modulation delay which can be adjusted by pressing “4” once on the additional parameters page.

Pitch Wheel

The Pitch Wheel Range and Assignment can now be selected and, if required, the Pitch Wheel can be calibrated.

###### Pitch Wheel Range

The range of the Pitch Wheel can be set to Octave, Fifth, Minor Third or Second. To set the Pitch Wheel range press the “6” twice on the additional parameters page and use the “Speed” knob to select it.

###### Pitch Wheel Assignment

The Pitch Wheel can be assigned to the control the Pitch (the default setting), the Filter Cutoff Frequency, Volume or Off. To select the Pitch Wheel assignment press the “6” once on the additional parameters page and use the “Speed” knob.

###### Pitch Wheel Calibration

The Pitch Wheel might need to be calibrated to its center position to properly sweep the full range selected. To calibrate the Pitch Wheel:

1. Center the Pitch Wheel.
2. While maintaining “from tape” pressed Press the “3” button on the keypad. The display will indicate that the Pitch Wheel has been calibrated.

###### Modulation Wheel

###### Wheel Depth

The range of the Modulation wheel can be set for Full, High, Half or Minimum to control the depth of modulation over the range of the wheel. To set the Modulation Wheel depth press the “3” once on the additional parameters page and use the “Speed” knob to select it.

Wheel Target

The Modulation wheel can either control the LFO or the Vibrato, the other being controlled by the modulation delay. Pressing “4” twice on the additional parameters page and using the “Speed” knob changes this.

###### Modulation Delay

The modulation delay can be adjusted by pressing “4” once on the additional parameters page.

###### Envelope Generator Mode

Four Envelope Generator (EG) modes are supported for both the Amplifier and the Filter: Fast Linear, Slow Linear and Fast Exponential and Slow Exponential which controls the response of the slope of the rise and fall of the attack, decay and release phase. To select the desired response:

For the Amplifier EG:

1. If you are in preset mode, make sure “to tape” is lit, else press it to access the additional parameters page.
2. Press the “5” once on the additional parameters page and use the “Speed” knob to select it.

For the Filter EG:

1. If you are in preset mode, make sure “to tape” is lit, else press it to access the additional parameters page.
2. Press the “5” twice on the additional parameters page and use the “Speed” knob to select it.

###### Oscillator Range Control

Oscillator A and B frequency ranges are now controllable in three modes: Octave (the default value), Chromatic and Free. The range remains the same but it is now possible to sweep the frequency of the oscillators with a greater or smaller degree of fine control. To select the oscillator sweep mode, press button “8” twice on the additional parameters page and use the “Speed” knob to select it.

Midi Channels

Miscellaneous Settings function “1” selects the MIDI receive channel, it can be “OMNI” to receive on all channels.

Miscellaneous Settings function “2” selects the MIDI send channel. The Prophet 600 will transmit note on / note off from the keyboard or the arpeggiator, plus pitch bend wheel and modulation wheel changes.

Voice Defeat

One or more voices from the Prophet 600 can be turned off. This can be useful if e.g. they aren’t working fine.

Use Miscellaneous Settings function “5” to select a voice number from 1 to 6, and function “6” to turn it on or off.

Synchronisation source

Miscellaneous Settings function “8” allows for one of three synchronization sources to be selected for the arpeggiator:

1. Internal: this is the default setting, the Prophet 600 will generate its own clock.
2. MIDI: a fraction of the incoming MIDI clock will be used to clock the arpeggiator.
3. Tape: you can plug any pulse clock source on the “Cassette in” jack. A fraction of it will be used to clock the arpeggiator.

###### Managing Sound Libraries through SysEx

###### Loading

Loading a SysEx library will overwrite your existing stored patches. To load a complete SysEx Library:

1. Connect the instrument via MIDI.
2. Load the SysEx file into a utility or into your sequencer application. Good utilities include:
  1. Windows: http (http://www.midiox.com/):// (http://www.midiox.com/)www (http://www.midiox.com/). (http://www.midiox.com/)midiox (http://www.midiox.com/). (http://www.midiox.com/)com (http://www.midiox.com/)/ (http://www.midiox.com/)
  2. OSX: http (http://www.snoize.com/SysExLibrarian/):// (http://www.snoize.com/SysExLibrarian/)www (http://www.snoize.com/SysExLibrarian/). (http://www.snoize.com/SysExLibrarian/)snoize (http://www.snoize.com/SysExLibrarian/). (http://www.snoize.com/SysExLibrarian/)com (http://www.snoize.com/SysExLibrarian/)/ (http://www.snoize.com/SysExLibrarian/)SysExLibrarian (http://www.snoize.com/SysExLibrarian/)/ (http://www.snoize.com/SysExLibrarian/)
3. Determine the appropriate transmission channel of the SysEx utility or sequencer application.
4. Set the Prophet 600 receive channel to the same channel that the SysEx will be transmitted by either selecting the specific channel or simply selecting OMNI (receive on all channels).
5. Transmit the data to the instrument.

Saving

Miscellaneous Settings function “6” will send a SysEx dump of all presets on MIDI out. Use your favourite SysEx utility to store it.

###### Troubleshooting and Bugs

This version of the firmware has been tested on many Prophet 600s. Issues may still arise in an instrument manufactured over 30 years ago operating in varied environments; components age unevenly. We invite you to submit issues and bugs but understand that in some cases issues might have to do more with the physical characteristics of the instrument than with software. Here are couple of things to think about:

1. Switch the instrument off, think of your grammar school teacher and then switch it back on again. Often, this all that is needed to restore the instrument.
2. Check your MIDI is properly set-up. Is it transmitting messages that might be causing the instrument to misbehave. Filter those messages.
3. Check for a new hex file for an updated firmware version.
4. How did the instrument operate before the upgrade? If the instrument becomes unstable, restore the original Z80 and observe the behaviour.
5. Power Supply: Unstable power supplies can cause a lot of issues with digital/analogue hybrid synthesisers.
6. Locked or unstable parameters: Pots can generate unstable voltages that toggle between two states. This was not an issue when the resolution on the Prophet 600 was lower, say four or six bits. However, with higher depth resolution, you might hear the artefacts of dirty or faulty pots causing slight wavering in the sound. Particularly susceptible parameters include the Pulse Width and the Filter Cutoff with a high Resonance setting. The solution is to clean the pot, change it or move the pot to a new location. You can also use a MIDI controller to set values and then store them.
7. Keep abreast of changes and report issues at Github-Issues: https (https://github.com/gligli/p600fw/issues):// (https://github.com/gligli/p600fw/issues)github (https://github.com/gligli/p600fw/issues). (https://github.com/gligli/p600fw/issues)com (https://github.com/gligli/p600fw/issues)/ (https://github.com/gligli/p600fw/issues)gligli (https://github.com/gligli/p600fw/issues)/ (https://github.com/gligli/p600fw/issues)p (https://github.com/gligli/p600fw/issues)600 (https://github.com/gligli/p600fw/issues)fw (https://github.com/gligli/p600fw/issues)/ (https://github.com/gligli/p600fw/issues)issues (https://github.com/gligli/p600fw/issues).

###### Appendix

###### MIDI Implementation

Two types of MIDI controllers are implemented:

1. Continuous parameters: 0-16383 using 2 CCs, or 0-127 using only the coarse one.
2. Stepped parameters: 0-127, variable number of steps. They work by dividing the 0-127 range is as many zones as there is choices for the parameter. E.g.: "Unison" is off for 0-63 and on for 64-127.

The Prophet 600 receives Continuous Controllers in Preset mode only.

###### Resources

Project Site: http://gligli.github.io/p600fw/

Issues/Bugs: https (https://github.com/gligli/p600fw/issues):// (https://github.com/gligli/p600fw/issues)github (https://github.com/gligli/p600fw/issues). (https://github.com/gligli/p600fw/issues)com (https://github.com/gligli/p600fw/issues)/ (https://github.com/gligli/p600fw/issues)gligli (https://github.com/gligli/p600fw/issues)/ (https://github.com/gligli/p600fw/issues)p (https://github.com/gligli/p600fw/issues)600 (https://github.com/gligli/p600fw/issues)fw (https://github.com/gligli/p600fw/issues)/ (https://github.com/gligli/p600fw/issues)issues (https://github.com/gligli/p600fw/issues)

Teensy Site: http (http://www.pjrc.com/teensy/index.html):// (http://www.pjrc.com/teensy/index.html)www (http://www.pjrc.com/teensy/index.html). (http://www.pjrc.com/teensy/index.html)pjrc (http://www.pjrc.com/teensy/index.html). (http://www.pjrc.com/teensy/index.html)com (http://www.pjrc.com/teensy/index.html)/ (http://www.pjrc.com/teensy/index.html)teensy (http://www.pjrc.com/teensy/index.html)/ (http://www.pjrc.com/teensy/index.html)index (http://www.pjrc.com/teensy/index.html). (http://www.pjrc.com/teensy/index.html)html (http://www.pjrc.com/teensy/index.html)
