gligli/p600fw/documentation/pictures/4a_solder_wires.jpg

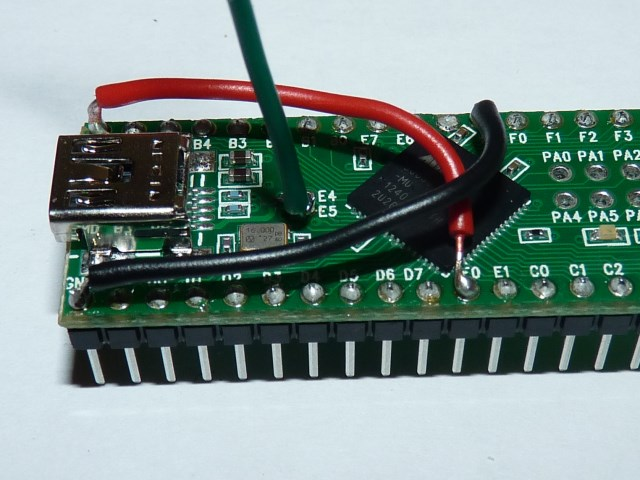
documentation/pictures/4a_solder_wires.jpg
