gligli/p600fw/(threads)

Thread 47 (2014-10-06):

Display parameter value briefly in preset mode

polluxsynth, 2014-10-06:
It would be nice if the potentiometer values were displayed also in preset mode. One way to do this would be that when turning a knob, the value would be displayed for a couple of seconds, before reverting back to the preset number.

gligli, 2015-01-25:
See #48

Closed 2015-01-25.

Thread 49 (2014-10-24):

At power up, always starts in MIDI sync

polluxsynth, 2014-10-24:
When powered up, the machine is always set to MIDI sync, regardless of what the previous setting was. Suggestion: save the sync setting so that when powering up it is the same as before.

gligli, 2015-01-25:
I really do'nt know what could cause this, is it still an issue?

polluxsynth, 2015-01-26:
Tested it again with the latest firmware built from the master branch, and it seems to work now. So don't know if it actually was an issue once, or I was mistaken. At any rate, it works now, so I'll close this one.

Closed 2015-01-26.

Thread 53 (2014-12-05):

Fifth setting for pitch wheel range goes instead up a fourth

mcasey1, 2014-12-05:
I have calibrated the pitch wheel and al other pitch wheel range settings work as they should.  Has anyone else experienced this issue?

gligli, 2015-01-24:
Indeed, the third was also wrong (should have been a major third)

Closed 2015-01-24.

Thread 54 (2014-12-20):

Filter CV in

waitgodot77, 2014-12-20:
my filter cv in is not working anymore after the upgrade! is there still an issue open, which i can't find?

gligli, 2015-01-24:
It was fixed since 2.0 and should work in latest alphas.

Closed 2015-01-24.

Thread 56 (2015-01-30):

MIDI clock received during upgrade causes upgrade to fail

polluxsynth, 2015-01-30:
If a MIDI clock is received during an upgrade, this causes the upgrade to fail. While this is not something one would to knowingly, it is easy to have, say Cubase running, with the MIDI clock output set to Continuous, and try to perform an upgrade simultaneously.

I have not checked the actual MIDI data stream, but I would think that the MIDI clock, being a MIDI Realtime message, can be inserted in the middle of a sysex package, which the boot loader then cannot handle. The upgrade begins as normal, with U shown in the P600 display, but as soon as the upgrade sysex data is sent, the display changes to E. So the boot loader apparently properly waits for the sysex status byte, and it is later, once the sysex transfer has started, that the problem occurs.

Fixing it I suppose would not help existing units which are upgraded via MIDI, but should be noted in the manual anyway.

gligli, 2015-02-08:
Any MIDI message sent while sending a SYSEX firmware update frame would make it fail, but given that the MIDI parser while in update mode is really primitive, I think it's better to leave it as-is and just add a warning in the manual.

polluxsynth, 2015-02-08:
I agree, probably not worth fixing, but a warning in the manual would definitely help as it would set users along the right path if they cannot upgrade successfully.

Thread 59 (2015-03-01):

Sysex current program dump request?

hotswank, 2015-03-01:
I know holding FROM TAPE and hit PROGRAM 6 dumps ALL presets (which is very nice because this wasn't possible before), but I want to dump the current program bank only (by holding RECORD and hit PROGRAM 2, or sending F0H, 01H, 00H, 0ppp ppp, F7 in Logic Audio in the old Z80). This used to send the 16 bytes of the stored Non-Volatile program that is displayed in the PROGRAM display. Could you please put this back and let us know what the new dump request code will be, thanks!

PS will this dump all the extra new parameters as well? Could you please publish the new p600fw 2.1 program bit map? (like the old Z80: http://users.skynet.be/aemit/seq/p600.html). I'm re-building a my old P600 editor in Max and need to now the new program bit map.

gligli, 2015-03-07:
https://github.com/gligli/p600fw/blob/master/documentation/sysex_format.ods now has the info you need, it's still a draft, some things may be wrong. next alpha will support a SYSEX patch dump request too.

hotswank, 2015-05-07:
Disclaimer says "some things may be wrong", I asume you mean the "patch format identifier" [A5 16 61 00] and the "patch format version" [02]? The sysex dump in the latest may 2 alpha shows it's resp. [25 16 61 02] and [0]. Is this correct? It should have said "0x25 0x16 0x61 0x02" and "0x00"?

Furthermore I would exactly like to know what bit is doing what in MSB and LSB and what the max. values are, just like the original Z80 program bits map diagram from my first link. I would like to rebuild my editor in Max MSP and decode the MSB and LSB bits with objects like funnel, spray, peek and poke and convert them to decimals so the can reflect the current parameter values to the dials and switches upon receiving the sysex data (thank you for the single sysex program dump code btw!). The editing will be done by your dedicated MIDI controllers. I really hope you can provide me all the info I need and how the MSB LSB bits are organised. Thanks again!

hotswank, 2015-05-07:
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

gligli, 2015-05-08:
Dont forget the "Encoded data format" layer, it's purpose is to be able to pass 8bit values through 7bit MIDI SYSEX, you can't directly read/write patch data from the sysex dump.

Data is MSB first. All continuous parameters are 16bit and use the full range (0-65535) to represent paremeter value. Some parameters are dual sided and so the middle value is the center (32768).

hotswank, 2015-05-12:
I'm trying to figure out your encoder and it's really, really doing my head in :) First off, how do you count the 32 raw data bits and why do you repeat after only 4 Bytes? (encoded to 5 if you include the 32-23-15-7 padded MSB Byte) while normal MIDI data is send per 8 Bytes?

From right to left?
Byte 0 - 31 30 29 28 27 26 25 24 ; Byte 1 - 23 22 21 20 19 18 17 16 ; Byte 2 - 15 14 13 12 11 10 9 8 ; Byte 3 - 7 6 5 4 3 2 1 0

From left to right?
Byte 0 - 0 1 2 3 4 5 6 7 ; Byte 1 - 8 9 10 11 12 13 14 15 ; Byte 2 - 16 17 18 19 20 21 22 23 ; Byte 3 - 24 25 26 27 28 29 30 31

And how do you put back/count the encoded 7-bit bits (and order) when they are send?
Because if you count the raw data bits from right to left and encode them, the first 7 bits of the 32 bit chunk of input data (bits 0-6), represent the 3rd Byte of the Patch format identifier 0x61, followed by 0x16 (bits 8-14), followed by  0x00 (bits 6-22), followed by the Patch number, followed by the MSB Byte which doesn't make sense if the first 5 Bytes of the encoded 7-bit sysex dump looks like this: 0 25 61 16 2 ... it looks as if the send encoded Byte order is left to right???

PS I'm trying to 'visualize' the encoder in an Excel sheet and will upload a screendump as soon as possible pending your reply.

hotswank, 2015-05-12:
The only way I can match the first 4 Bytes of the 8-bit raw data with the encoded 7-bit MIDI data is if the count order is like below because it's the only way 00h A5h 16h 61h 00h translates to 00h 25h 16h 61h 02h send by 7-bit MIDI MSB first... :

Byte 0 - 7 6 5 4 3 2 1 0 ; Byte 1 - 15 14 13 12 11 10 9 8 ; Byte 2 - 15 14 13 12 11 10 9 8 ; Byte 3 - 31 30 29 28 27 26 25 24

hotswank, 2015-05-12:
For the life of me, I can't figure it out, something doesn't add up.... and I really tried :)

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

gligli, 2015-05-12:
Ok, version number has been bumped between writing the spec and last alpha, hence why you get 7 instead of 2 as version. Version 7 adds microtunings per patch at the end of data, everything else is the same.

Seems like "osc a freq" is $fff0 in your example, it makes sense if the pot is fully clockwise (bytes are little endian ordered, ie the low byte of a 16bit word is stored first. I should probably write this in the spec)
That makes "osc a volume" $ff00 (fully clockwise, only 8bit pot scanning so the low byte always stays 0) and "osc a pw" $ffc0 (fully clockwise, 10bit scanning)

hotswank, 2015-05-12:
Is there anything else you haven't told us? LOL but thanks! Not sure if I understand now... so the only Bytes that are not MSB first are OSC A/B freq, OSC A/B vol and OSC A/B pw? Are you going to update the sysex_format.ods file in the master/documentation any time soon? Ooh and before I forget, are the switch bits i.e. LFO Mode Destination etc. specs notated in Hex or Dec? Would you like to publish your encoder code in Java/C++ or whatever? Thanks again!

gligli, 2015-05-12:
Data is all most significant bit first, but 16bit values are all encoded in little endian (ie least significant byte first, still those bytes are MSB), that's how it's handled by the avr architecture.
By the way, the fact that the lower bits are zero is not a requirement, just a concequence of how the pots are scanned.

I don't know but I need to clarify the 16bit values encoding and new patch format version yeah, as I said It's a draft, I made it because people requested it. The format itself is just a dump of the internal storage format, packed in a MIDI friendly way, not really something made to be easy to parse.

It's decimal, eg. "LFO mode dest" is a bitfield of those values.

Well, the code is in p600fw, mostly in storage.c and midi.c, but I think I'd better focus on improving the spec instead of implementing it in another language.

hotswank, 2015-05-13:
I have tried everything but something isn't right, sorry for my ignorance... Question remains how you count the bits in the input data stream and is the order of the last MSB Byte in the encoder correct (31 23 15 7)? Back to counting: do you treat each 32 bit chunk of raw input data as a 32 bits Byte or do you splice them up in 4 Bytes of 8 bits each?

[ 31 30 29 28 27 26 25 24 23 22 21 20 19 18 17 16 15 14 13 12 11 10 9 8 7 6 5 4 3 2 1 0 ]
or
[ 7 6 5 4 3 2 1 0 ] - [ 15 14 13 12 11 10 9 8 ] - [ 23 22 21 20 19 18 17 16 ] - [ 31 30 29 28 27 26 25 24 ]

Please take a carefull look again at my screen dumps to clarify the counting issue. As you can imagine, a incorrect counting order will skew the MSB Byte! I've have tried to project the sysex dumps from parameters OSCA freq 0 - 5, OSCA vol 0 - 99 and OSCA pw 0 - 99 and whatever I try, the 3rd MSB Byte (32 23 15 7) does not add up correctly!

freq 4 vol 99 pw 99:
60 10 4 0 7F 40 7F 0E
freq 5 vol 99 pw 99:
10 14 0 0 7F 40 7F 0E
freq 6 vol 99 pw 99:
70 19 4 0 7F 40 7F 0E
freq 99 vol 99 pw 99:
70 7F 0C 0 7F 40 7F 0E

hotswank, 2015-05-14:
I'm very sorry to be such a pain but I'm still trying to figure out how to count the 32 bits from raw input data into the encoder:

A) As one big chunk of 32 bits from R to L
Byte-0-1-2-3 [bit 31 < 0]

B) As one big chunk of 32 bits from L to R
Byte-0-1-2-3 [bit 0 > 31]

C) As 4 seperate Bytes, 0 starting at Byte-3 from R to L
Byte-0 [bit 31 <  24], Byte-1 [23 < 16], Byte-2 [15 <  8], Byte-3 [bit 7 <  0]

D) As 4 seperate Bytes, 0 starting at Byte-0 from L to R
Byte-0 [bit 0 > 7], Byte-1 [bit 8 > 15], Byte-2 [bit 16 > 23], Byte-3 [bit 24 > 31]

E) As 4 sperate Bytes, 0 starting at Byte-0 from R to L, repeat for every Byte from L to R
Byte-0 [bit 7 <  0], Byte-1 [15 <  8], Byte-2 [23 < 16], Byte-3 [bit 31 <  24]

I'm pretty sure B) and D) are not valid because bits are always counted R to L [7 < 0].
Yet, if we count the raw data bits from R to L, as per A) and encode the first 32 bits chunk, starting with (bits 0-6), it represents Byte-3 of the Patch format identifier [0x61], followed by Byte-2 (bits 8-14) [0x16], followed by Byte-1 (bits 16-22) [0xA5], followed by Byte-0 (bits 24-30) Patch number [0x00], followed by the MSB Byte (bits 31 23 15 7), the sysex dump would look like this: 61 16 25 0 2

But if we look at the actual encoded 7-bit sysex dump, it says 0 25 61 16 2 ... so it does look like the 32 bits counting is L to R, as per B) unless the encoder also reverses the Byte order just like it does with the 16-bit WORD bits (little-endian).
If it doesn't switch Bytes and we look at the MSB conversion Byte of 0xA5 = 0x25, the only possible count order is C)...

In conlclusion: I really, really need to know the correct bit count order...

gligli, 2015-05-14:
If the raw input is 4 bytes in normal left to right order, eg:
A; B; C; D
Then the result should be, in normal left to right order:
0; A6-0; 0; B6-0; 0; C6-0; 0; D6-0; 0000; D7; C7; B7; A7

But you want to do the opposite, ie start from encoded data and decode it. So, this encoded chunk of 5 bytes:
V; W; X; Y; Z
Becomes, by reversing the process:
Z0; V6-0; Z1; W6-0; Z2; X6-0; Z3; Y6-0

Actually the spec was somewhat wrong, MSB and LSB ordering were mixed in the encoded data format, sorry for that.
I just pushed some fixes to the spec, including this.

hotswank, 2015-05-14:
Thank you very much! Another 3 days of my life gone heheh... but hey, you spend several months coding the new firmware so I will not complain! BTW Just d/l the new sysex_format and did notice the My Patch format version is still at 0x02 (should be 0x07) and the Modulation delay, Vibrato frequency, Vibrato amount, and Unison detune still say "unsigned" only, I guess they should be "unsigned, little endian order" just like the others?

gligli, 2015-05-14:
Patch format version 7 is from the latest alpha only, and only if the patch was written in that version, otherwise it's still version 2. For now it's better to use 2 if you write SYSEX patches yourself and just ignore the new stuff from v7.

I fixed those too, they are the same as the others now.

Thread 60 (2015-03-09):

Polyphonic sequencer

polluxsynth, 2015-03-09:
Instead of having monophonic sequences, they could be polyphonic, similar to the step sequencer in the Poly-800.

polluxsynth, 2015-03-09:
I've implemented a polyphonic sequencer now, it's still really only alpha, as I have not yet had a chance to test it on a real P600, only on my simulator in Linux, which operates via MIDI.

Anyway if you're feeling adventurous you can check it out. https://github.com/polluxsynth/p600fw/tree/polyseq

I was going to be more ambitious and have the possibility of having notes that did not necessarily all start and stop at the same time, as I believe the Poly-800 can do that. However, I ran into a problem with the transpose function, as it would mean having a note buffer covering the whole keyboard, where the value of the transposition for each note played would have to be entered, in order for the runtime transpose function to work properly. Since that would have required 61 bytes of RAM for each sequence, I opted to scrub that idea after some work on it and instead go with your suggestion of extending the existing format so that chords are stored as a normal events with an additional flag indicating that it's part of a chord.

I've changed the UI somewhat, so that there is now one UNDO/BACK (1) button and one STEP  (2) button. STEP works as TIE or REST did before, depending on whether it is pressed when a  key is pressed (TIE) or when no keys are pressed (REST). To me it makes note entry easier, as one can play rhythmically with one hand on the keyboard and the other on the 2 button.

The UNDO/BACK button (1) backs up one full set of events, i.e. a whole chord, or a tie or rest event.

Since my original idea would have required two bits per event, I remapped the keyboard codes so that in the sequencer they are stored as 0-60, leaving 61, 62, 63 for special events such as rests and ties, and bits 6 and 7 for auxilliary functions. As it is, bit 7 is the CONTINUE bit indicating that a note event is part of a chord rather than a new step, and bit 6 is unused. Perhaps useful for some future expansion.

I've also changed all the track length arrays in the seq struct to one large track struct, which in turn is put in an array in the seq struct. It makes the code easier to read and also seems to take up less space in the binary.

I've done some testing, but like I said, only in my simulator, so I'm hesitant to enter a pull request at this time.

gligli, 2015-03-11:
Cool! I haven't tested it yet, but I think we should include those changes for 2.1.
Will those changes still allow to play existing sequences? Not sure about old vs new internal tie & rests encoding.

gligli, 2015-03-11:
Well, there's a problem, the binary from your version is bigger than 65536 bytes, for now it can't be flashed using SYSEX.
The flash storage zone starts at offset 65536 and presets are stored at the beginning of it, there's actually about 24KB of unused flash in the middle of it, so I tried to move some code there, but no success for now...
Hopefully I can make it work, else adding more stuff to p600fw will prove very difficult, not that there's a lot left to add tho.

polluxsynth, 2015-03-11:
Ok, starting with your first comment, I haven't designed it so that it can play old sequences, if nothing else the note coding is different as I subtract 24 so that the notes are encoded with 6 bits, leaving to bits for flags. As it turned out, only one flag bit (SEQ_CONT) is actually used; originally I used both bits, one for note on/off, and one indicating that it's the start of a new step. Since the sequencer has not been in any official release yet I figured maintaining backward compatibility wouldn't be necessary. If you think it's important backward compatibility could probably be added with not too much trouble.

As for the second problem, I just got word yesterday that my P600 tester (i.e. my friend who owns a P600) had tried to flash the new version and the synth ended up acting very erratic. I was going to have a look at it this weekend, but good job you figured out what it was.

Is there anything I can do? Sounds as if the problem is related to the memory organization which I'm not very familiar with, certainly not on your level at this point. I could look at trying to optimize the code, but since it ends up being 67072 that's 1.5k too much and it would seem unlikely that it could be optimized so much that the code got cut down by that amount.

polluxsynth, 2015-03-12:
I was browsing through the code and I'm wondering if some space couldn't be saved by trying to replace  the float/double operations with fixed point operations using integers.

I did an experiment. First I temporarily removed all explicit calls to exp(), and measured the size of the text segment (exp() is still included as it is used by pow()). Then I replaced  pow(2.0, val) by (1UL<<val) in tuner.c (and foo*pow(2.0, val) with foo/(1UL << val)), making the whole pow and exp functions disappear from the binary. The difference in text size was 874 bytes, which is quite substantial. Admittedly, the exp() functions would have to be added back in somehow which will take up space. But I'm wondering how much could be saved by going on and replacing all float/double operations with fixed-point operations, realized using just integers.

cos() could be replaced by generating a cosine wave using basic DSP type operations, or a pre-calculated table if that is shorter. (The table is 256 uint16_t's long, which is 512 bytes, and it seems to store half a period of a sine wave (pi to 2*pi), but one could store only half of that and mirror it during init to get a complete half wave).

exponentialCourse is a tougher one. Would have to think about that.

gligli, 2015-03-14:
Ah well, I was afraid of if but I'm now sure there's a subtle bug in the updater code that prevents it from flashing anything above or equal to offset 65536.
The updater is is a chunk of flash that can't be live updated, so we're basically stuck with this problem forever if we want to keep the updating process as simple as it is today.

So yeah, I think the best option we have is to find a way to make the binary fit in 65536 bytes.

gligli, 2015-03-14:
Problem solved by commit https://github.com/gligli/p600fw/commit/0ce5d37d35395b698d24c3d5d14d820d71d0bba8 , binary down to 45KB :)

gligli, 2015-03-14:
I tested the new sequencer a bit, it's actually really cool to be able to have chords on a track, bass on another and then jam on it!
I found 2 relatively minor issues:
- You can add a single key many times to a chord, at first it works a bit like unison, but if you do it a lot of times, it ends up hogging all CPU ressources as you play the sequence.
- If you try to start both sequences at the same time by pressing both buttons at once, one of the sequences often gets delayed by one step, odd.

polluxsynth, 2015-03-14:
Great about the -O2, I never even thought to check the compiler options (or if I had I might not even have dared change it as I remember how the code failed to run properly with optimizations switched off completely).

Glad you like it. As for the two issues, the first one is something I forgot, I was planning to avoid adding a note to a chord if it was already to be entered, to avoid this situation, as the resulting unison would not be something one naturally would think would happen. Rather if one removes notes from a chord, the idea is that the user has pressed a note by mistake, so if a note is pressed again it would be because he realized he had in fact not made a mistake and did want the note to be inserted.

I'll have a look at that as soon as I can. I wonder why it hogs all CPU resources though, it should just send a bunch of note ons to the synth which shouldn't be different from them arriving via MIDI from, say, a master keyboard.

The second one I've not been aware of, thanks for mentioning it, I'll have a look and see if I can figure out what's happening.

polluxsynth, 2015-03-15:
I've now tried to fix the two issues. It's now not possible to add duplicate notes to a chord. I haven't limited the number of notes though (useful when playing an external sequence), so I don't know if the same CPU hogging will happen if lots of (different) notes are entered at once anyway.

The second one was rather intricate. I think the problem was there also in the monophonic sequencer. I've tried to explain it in the commit message and also in the code; basically, the root of the problem is that seq.conter was set to INT16_MAX whenever a new sequence was started, which means that if both sequences are started at the same time, as soon as seq_resetCounter() happens for the second one, it will cause the first step of the first sequence started to be cut short. Since both sequence buttons are pressed virtually simulatenously from the user's point of view (but sequentially from the software's point of view), the first note of the sequence which happens to be first is cut short and in practice not heard at all.

Anyway, please give it a try, I've re-pushed my polyseq branch referenced above (do note that I've modified the "alpha" message in the firmware to reflect the fact that it is not one of your alphas) with the new changes. Again, so far only tested in my simulated environment.

gligli, 2015-03-15:
Seeing the code, I can't explain it but it seems it can't get out of record mode now. Hitting play sometimes even corrupts RAM (garbled displayed text).

polluxsynth, 2015-03-15:
It's not something basic like the fact that I git rebased my polyseq branch bringing in your latest changes on master (-O2 in the Makefile) so that you need to do a complete make starting with make clean?

polluxsynth, 2015-03-18:
Did commit b7dc537e24bb4907859a8e46eac82228c3498588 and/or 6504831ce84edb74a653337f12db54f44e594ad2 solve the problems with the sequencer?

gligli, 2015-03-19:
Ah, I don't know, I'll have to check, that problem I had could be related to storage yeah.

polluxsynth, 2015-03-19:
I'll try to lay my hands on the P600 for some testing here, it might take a week or so though.

polluxsynth, 2015-04-04:
Finally got the P600 home for testing. I'm working with my polyseq branch:
https://github.com/polluxsynth/p600fw/tree/polyseq

I can't get out of record mode either. I have debugged it so far as the variable tp in seq.c:seq_setMode() on my branch, which is set to point to the track struct for the track in question. It seems that calling storage_saveSequencer() changes the value of the variable?! In the particular build I'm working with it is 0xEEF before the call and 0xE00 afterwards (determined by saving the value of the pointer in a static variable, and comparing it after the call, then sprintf:ing the values to a string and sevenSeg_scrollText:ing it if they differ). Removing the call to storage_saveSequence() causes the bug to go away (but of course the sequence is not saved then).

This seems very odd to me. The two possibilities I can think of now is that either there is a compiler bug which for instance causes the registers that tp are stored in not to be saved properly across the call, or there is some function called by storage_saveSequencer() which either corrupts the stack (if tp is on the stack) or corrupts a register it shouldn't touch (if tp is in one or more registers). Either way it's strange it doesn't happen anywhere else in the code. Of course very few functions actually save something to storage, so if it is something called by storage_saveSequencer() (e.g. something in teensy_bootloader_hack.h) it would only be visible to a few functions.

polluxsynth, 2015-04-04:
I don't have the P600 set up so I can easily reflash the bootloader so I can't test this at the moment, but looking at teensy_bootloader_hack.h, in blHack_page_fill there is a movw r0, %4, yet of the register pair r0:r1 only r0 is listed in the clobber list in the __asm__ statement.

gligli, 2015-04-05:
The code in teensy_bootloader_hack is mainly a copypaste of a gcc file iirc, the difference being that istead of calling "spm", here we have to call a piece of the bootloader.
I'm thinking that call to teensy bootloader does more than just spm, maybe it thrashes some registers too.
I think the best thing to do is to store all regs, eg to stack, before the teensy bootoader call and restore them after. Or maybe in storage_write() so that it can be effective when updating thru SYSEX.

I'm currently moving out so I can't work on p600fw, I should be back on it maybe next week end.

polluxsynth, 2015-04-06:
Yes, I was wondering if the SPM call does something else apart from SPM too, or if the address to it is off by a couple of bytes so it does something unrelated before the SPM? How has the SPM call address been determined? I would think it would be possible to read the code at that address to see what is really going on?

Anyway, I added an __asm__ statement to storage_write which effectively just tells the compiler that R16 is clobbered, causing it to push and pop that register in that function. This cures the problem. You're right, perhaps more registers should be pushed. Still, I could tell that R17 (the high byte of R16:R17) was unchanged through the call anyway, so I'll just leave it at R16 for now.

I've pushed the new version to https://github.com/polluxsynth/p600fw/tree/polyseq .

I've also attempted to fix the problem of the arpeggiator and sequencer not running in sync (they run at the same speed but the note ons are synchronized to when the sequence was started, or note pressed when it comes to the arpeggiator, rather than each other when both are running). It's at
https://github.com/polluxsynth/p600fw/tree/arpseqsync . There's still a bit of work on it needed, as the arp and/or seq get out of sync with the beat as they reset the clock as soon as the respective button is pressed, which I believe should not happen in MIDI sync mode

Closed 2015-05-02.

Thread 61 (2015-03-15):

Sync to midi clock

mink99, 2015-03-15:
The values that can be set for the clock divider for the arpeggiator and sequencer range from 0-127.
As midi clock is set at 96 ticks per beat, I would suggest either
... To give it a range from 3 to 96 so that the given entry would be the divisor from 96 as
3 would be a 32th note, 6 would be a 16th, 8 a triolic 8th etc...
... To give it a fixed range of values : 1/1 1/2 1/4 1/8 1/8t etc

It would be an enhancement to have this divisor stored globally and not per patch, as patch switching in a sequence creates unpredictable rhythmic results.

Sometimes, when a sequence is stopped, the note-offs are not send, therefore we have hanging notes. A short "all notes off" when stopping a sequence would help.

The sequencer still seems to be some kind of jittery, maybe when the divisor can be set in a documented way, I would like to offer my help in testing this

Regards Kris

gligli, 2015-03-15:
There's already a fixed range of values, the possible divisors to midi clock are: 384,192,168,144,128,96,72,48,36,24,18,12,9,6,4,3,2,1

Storing it globally doesn't seem like a bad idea. I could also remove 2 divisors to make the 0-127 range nicely split in 16 divisors.

Hmm, which alpha are you using? There was problems with hanging notes in old alphas but I thought it was fixed in recent ones.

The sequencer is updated at 500 ticks per second, so worst theoretical jitter would be 2ms. Some actions could make it worse tho, eg loading another patch or changing settings.

mink99, 2015-03-15:
Hi,
I am using the http://sfx.gligli.free.fr/zik/p600/dev/2015-02-22/p600firmware.syx. Version. The note hangs occur when the external clock is stopped, tested on a motu xl midi interface, which is reliable, so that we are not chasing ghosts...

It sounded as if the notes were shuffled, the test sequence was a
1 1 1 pause, independent of the resolution or tempo  it seemed as if the second and third step were shifted towards the beginning of the beat.  I will recheck.
There might have been a pebkac on my side, as I could not find a match between the 127 steps display and the divisors.

I am currently planning to build my own step-sequencer on arduino base , also with the poly-800 in mind. In this concept the useful steps are much less : 1/32 1/16 1/16t 1/8 1/8t 1/4 1/2 1/1 .  Where I am sure that even 1/32 notes will have issues due to the still- not- so--fast envelope generators.

One last thought, there are devices that permanently send midi clock and assume the synced devices to start after a midi start 0xFA and stop after a 0xFC. Some devices ignore this (volca) other respect it (mpc). I am not sure which approach would be better...

Thanks

Kris

gligli, 2015-03-15:
Ok, I just checked my git log, I commited a fix for that just after releasing 2015-02-22.

As I said, there is probably a bit of jitter, nothing that should be obviously out of sync tho.

I already made some changes to the way clock is stored, I chose to limit it to 16 divisors, removing the fastest and slowest ones and made it a global setting.
On the SW side, envs are as fast as they should be. On the HW side, aging S&H 4051 multiplexers can have a hard time following them, there's nothing I can do about it.

I think I just ignore clocks out of a start/stop right now.

mink99, 2015-03-15:
Please do not get my words on the envelope speed as critics on your work , this was never my intention. ... And sorry, I saw your last commit only after I had placed my last comment.

I will retest the next update / alpha and report back if that is ok for you

Regards Kris

gligli, 2015-03-16:
Hey, no problem, I just wanted to explain the reason why envs may still be slow.

Ok, next alpha will have lots of new stuff, probably including polyphony for the sequencer.

gligli, 2015-09-06:
I'll assume this is solved.

Closed 2015-09-06.

Thread 62 (2015-03-18):

Arp and sequencer clocks not synchronized

polluxsynth, 2015-03-18:
If the sequencer and arpeggiator are started at not the same instant, they will run at the same speed, but will not trigger at the same point, i.e. there will be a perceived delay between them.

polluxsynth, 2015-03-18:
I've made an attempt to fix this on the following branch:
https://github.com/polluxsynth/p600fw/tree/arpseqsync
Note however that it is built on top of the polyseq branch, so we need to get the bugs in the sequencer ironed out first.

polluxsynth, 2015-04-06:
I've updated the branch:
https://github.com/polluxsynth/p600fw/tree/arpseqsync
with the latest developments on the polyseq branch plus a few fixes after having had access to a real P600 for a couple of evenings. There's still a bit of work on it needed, as the arp and/or seq get out of sync with the beat if the respective button is pressed, which I believe should not happen in MIDI sync mode - to me it seems more meaningful to, for instance, if the divisor is set to run the sequencer/arpeggiator at 16 notes, always synchronize the sequencer and arpeggiator to the nearest 16th note.

polluxsynth, 2015-04-06:
I took the courage and adjusted the behavior of how the seq and arp resets. Now, when on external sync (MIDI or Tape), it keeps track of the 'beat', e.g. 16th notes if it's set to that, so that when pressing SEQ1, SEQ2 or triggering an ARP, the notes are in sync with the 16th notes, and not just running at the same tempo put potentially offset a number of clock pulses (depending on exactly when the SEQ or arp was started in relation to the incoming MIDI clock).

Again, updated https://github.com/polluxsynth/p600fw/tree/arpseqsync

Due for a bit more testing before I put in a merge request.

Closed 2015-05-02.

Thread 63 (2015-04-02):

Possible Race conditions

mink99, 2015-04-02:
Hi,
When the p600 is run from an external sequencer and receives midi clock / mmc (the internal sequencer is not running,) the midi stop command causes the p600 to switch from preset to parameter mode.

mink99, 2015-04-02:
This does not always happen... The condition when I could not reproduce ...

gligli, 2015-09-06:
MIDI bank select (CC#0) is used to change from preset mode to manual mode.
I suppose this was a glitch from the MIDI source, if you can reproduce it, feel free to reopen the issue.

Closed 2015-09-06.

Thread 64 (2015-04-06):

Starting arpeggio with notes held causes hung notes.

polluxsynth, 2015-04-06:
Hold down a chord, and press ARP UP/DN. The chord is silenced as would be expected. Now, release the chord, and press a note (preferably far away on the keyboard to make it more obvious). What will be heard is the new note being repeated as expected (i.e. arpeggiation on the sole note pressed), but on the 2nd and following triggers the notes from the previously held chord will also be arpeggiated, until the top note of the chord is reached, when the arpeggiation of the chord stops. The arpeggiated chord notes will not be released but will remain held, even if the chord is released from the keyboard.

Another symptom is to hold a chord, press ARP UP/DN (chord goes silent as expected), release the chord, press ARP UP/DN again (ARP LED turns off). Pressing and releasing the first note of the chord causes it to hang, as does the second note, etc. The highest note doesn't hang however but behaves normally. This behavior is also noted after the case described above, once the arpeggiator has been turned off.

Found on master commit 99e5df6fb33bfdee84c840a7e602a4c3681f9e0a .

Closed 2015-05-02.

Thread 67 (2015-04-18):

Pressing TUNE causes synth to emit a short blip

polluxsynth, 2015-04-18:
Pressing the TUNE button causes the synth to emit a short blip on the audio output. This seems to be due to the final volume VCA not closing fast enough (the time constant on the RC is in the region of 30 ms).

polluxsynth, 2015-04-19:
One thing I didn't understand when looking through tuner.c, is the way that DAC updates seem to happen very seldom. For instance, in tuneOffset(), sh_setCV() is used with the 'immediate' flag set to 0, so that the CV is actually not output until whileTuning() is called from measureAudioPeriod() (which admittedly is called very soon after). Is there a reason for not doing an sh_update() immediately when the CV has been set? Also, whileTuning() is among other places called from a loop in measureAudioPeriod(), which means that it continuously writes to the display during this time, which also seems unnecessary. This also means that it writes multiple times to the DAC by calling sh_update() in whileTuning(), is that to get a stable DAC value, or is it in fact to add a bit of delay, as there is a comment in measureAudioPerod() about that 25 loops with calls to whileTuning() is necessary to get the filter tuning working in a stable manner.

gligli, 2015-04-19:
Only one third of the display can be lit at the same time, hence the need to refresh it continuously.
The tuner is highly sensitive code, easy to break something on some P600s, I would recommend making the least possible amount of changes in it (you fix for the initial problem seem perfectly fine tho).

polluxsynth, 2015-04-19:
I don't really want to make any changes, mostly curious as to why it looked the way it does.

Closed 2015-04-30.

Thread 68 (2015-04-18):

First note played after power on for each voice may emit a 'thump'.

polluxsynth, 2015-04-18:
Some 3372 chips it seems have a larger CV feedthrough on the filter CV input than others. In the particular machine I have here one of the voices emits a fairly loud thump the first time it is triggered after power on. Looking at the input to the filter CV buffer the CV jumps rather far when the voice is triggered the first time, from 0V to a couple of volts. The voltage difference with max envelope is less tha this, for instance.

snickell, 2015-04-26:
I get this issue too.

Closed 2015-05-02.

Thread 69 (2015-04-18):

Easier access to sequencer keyboard transpose

polluxsynth, 2015-04-18:
In sequencer mode, it would be practical to be able to transpose the sequence by just pressing down a key, rather than having to hold FROM TAPE and press a key. This would be very useful if the player is playing another keyboard with the other hand, for instance.

A suggestion is to implement this by allowing a double press (i.e. two presses within a short time) on FROM TAPE to toggle the transpose mode on and off.

polluxsynth, 2015-04-19:
Sorry about all the references above, I've rebased my dev branch several times and re-pushed it ...
I'm not 100% convinced about the double click transpose mode, because if a user enters this mode by mistake it may not be obvious how to exit it. Since in this mode pressing a key doesn't play any notes but just sets the transpose, it could be somewhat serious as the machine is basically when playing the keyboard. I've tried to help this by exiting double-click mode if one does transpose in the traditional way (i.e. From Tape + key on keyboard), or when accessing any misc function.

The current implementation on my dev branch is as follows:
- Double-pressing (i.e. within one second) From Tape enters 'transpose' mode. The From Tape LED flashes, and all subsequent keyboard presses are regarded as transpose settings.
- Exiting transpose mode can be done by double-pressing From Tape, doing transpose the traditional way (From Tape + key on keyboard), or when accessing any misc parameter.

The advantage to this mode is that if the player only has one hand available, it's possible to transpose sequences (and arps!) using just one hand.

An alternative implementation would be to implement a misc function which toggles a setting enabling automatic transpose mode when the sequencer is running. I've tried this too and it works, however, since if one starts the arpeggiator at the same time one would not want the arp to be transposed from the keyboard, but instead be used for entering notes, it gets slightly awkward to use and hard to understand. I think it is simpler for the user to have a clearly indicated (flashing From Tape) transpose mode with a clear way of entering and exiiting it.

Closed 2015-05-02.

Thread 70 (2015-04-22):

Sysex messages don't seem to be receiving

snickell, 2015-04-22:
I think I have the "midi tuning standard" PR updates against master, but master seems to have had a regression on receiving sysex messages. I tested against master from a year ago and sysex messages do receive correctly.

Every time I try to transmit sysex to the p600fw, I'm seeing what looks like memory corruption somewhere in midi.c (and end up getting a "sysex message overflowed").

Any idea what commits might have affected this? I'll work on tracking it down, but its the sort of bug that's a little tricky w/o jtag!

gligli, 2015-04-22:
A memory corruption could occur because too much RAM is used for data and there's not enough left for stack, so do you think your changes use more RAM than master?
I know we're kind of short on RAM that's why it made me think about it.

snickell, 2015-04-22:
The issue occurs on unmodified gligli/master, so not something related to
my changes. There's some fairly convoluted pointer arithmatic going on in
midi.c, esp dealing with filling the sysex buffer, so I'm suspicious of
that area of things.

Unrelated thought: I don't know the specifics of the avr architecture and
how avr-gcc allocates memory, but I thought stack was usually a fixed size
allocation (so from a different memory pool than malloc which means 'using
more ram' shouldn't affect the stack unless you overflow the stack in a
particular frame).

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

snickell, 2015-04-22:
Sysex's receive correctly on d83dd7e (Oct 2013), but do not receive on current master b311b96 (Apr 2015). If I have time I'll try to isolate the commit that caused the regression.

gligli, 2015-04-22:
Another wild guess, it could be this commit, it made the sysex buffer smaller: https://github.com/gligli/p600fw/commit/7224ec8071e5dc2ac1f2e6e1ce614ce6118c001c

snickell, 2015-04-23:
I think that just changed the storage buffer, but I'll check if
before/after commit made a difference.

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

snickell, 2015-04-23:
Argh, my fault. I've had my midi in/out cables reversed, but the old 'echo' kept me from ever noticing :-P Sysex working fine, my fault entirely.

Closed 2015-04-23.

Thread 74 (2015-05-17):

Tuning issue

mwooten1, 2015-05-17:
Hi. Just some background info: This is my first vintage synth. I purchased it online anout a month ago from someone who had already installed the 2.0 update. It has been working perfectly until today. I was playing it and it drifted a little out of tune. I pressed the tune button and then afterward it was much worse. Now only one note (usually middle c but it drifts down to b or bflat) is in tune and everything around it drastically out of tune. Like not just really flat or sharp, if you play a chromatic scale straight up you just get two different random pitches for each note. I've tried everything I could think of and read the manual all the way through no luck. Any advice?

mwooten1, 2015-05-17:
The only thing that I did a little bit before the problem starter was kill some of the oscillators. This was my first time doing this so maybe that did something I don't know.

gligli, 2015-09-06:
Sounds like a hardware problem if it started acting without any firmwmare change. A failure related to the DAC could do this...
One simple way to rule it out is to try to do a full sweep with a pot, if the display doesn't jump / misses values, then that's probably not it.

Sorry for the late answer in any case, feel free to reopen if you think it's a software problem.

Closed 2015-09-06.

Thread 77 (2015-05-30):

Raw patch data format parameter swap?

hotswank, 2015-05-30:
Is it possible to 'relocate' the position of the 'Modulation wheel target' bits (incl. padding)? It would be better if it would come right after 'Modulation wheel range' and before 'Osc pitch mode'. This would not only be a more 'logical' position e.g. clustering similar parameters like Pitchbend before it, but more importantly, this would 'push' the 2x8 'Modulation delay' bits etc. in the 'next' cluster of 4 Bytes of the encoded data string. I'm not sure why you didn't do this, perhaps you had a very good reason for it?

Below is a picture of the 'before' and 'after' situation to get an idea what I'm on about!

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
PS If you are familiar with Max/MSP, ignore the [<< 7] cabling, they are wrong :)

hotswank, 2015-05-31:
While your at it :) would it be possible to add an extra padding byte at the end (before the 6*8 'Unison track pattern' bits) so bit 7 of 'Arpeggiator speed' is isolated from decoding the MSB byte of 'Unison track pattern' (and thus can be ignored). This will also allow me to visualize the 'Unison track pattern' as notes more easily.

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

gligli, 2015-05-31:
Actually I can't make any change to this format, it is basically how a patch is stored in flash, and it must be kept backwards compatible.
The format was extended for 2.0, so new parameters had to be added after the old ones, hence why some parameters are not where they should logically be.

hotswank, 2015-05-31:
Now that's a real shame :)!

Thread 81 (2016-02-15):

Problem with new teensy board

talycomosuena, 2016-02-15:
Hi friends,
I´m trying to install the upgrade for a Prophet 600 and I have a problem with the teensy board… seems to have some differences with the one of the installation pdf… the led is blue instead of orange… but the problem is with the tracks of the backside…
I´ve cut the link marked in the picture like you say in the installation manual…but continuity between 3.3 and 5v is still there…and the prophet don´t starts Tune neither the led of teensy blinks more than a ms when I put on the synth...…..
 I see that the PCB have a different way on the tracks… could you say me what tracks have I to cut?
Thanks a lot,
Best regards.
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

Closed 2016-02-16.

Thread 82 (2016-02-19):

midi cc's ?

lOl-Oscillators, 2016-02-19:
hi gligli,
thank's for your great work !
it's a pleasure to use all the new parameters !!
i just finished an ipad editor (with mididesigner) for the p600.
my questions:
- are there midi cc's for the 2 poly mode switches?
- is there a correctly working midi cc for amp EG fast/slow? (if i use cc64 it only holds all notes and not possible to switch them off anymore)
best regards
101 Oscillators

gligli, 2016-06-23:
Hi,
* Hmm, unison and assigner priority? should be CC65 and CC66.
* It should be CC73.

Thread 83 (2016-05-04):

Porting to teensy3 ?

mink99, 2016-05-04:
With a connector board it should be possible to move from the current teensy++ platform to a teensy3 platform. This would give much more free memory (bigger sequencer) and would open the opportunity to optionally replace the 2 digit led with a mini lcd (those 1.4") to provide better visual feedback.
The code should be portable, some 3.3 v <> 5v levelling would be required .

gligli, 2016-06-23:
It's probably doable, but at this point, it might be better to use a fully custom PCB as the level shifters would require a separate PCB design anyway.

Thread 84 (2016-06-23):

Update the manual to reflect changes made from 2.0 to 2.1

gligli, 2016-06-23:
My blog posts should help for this: http://gliglisynth.blogspot.fr/search/label/p600fw

numind06, 2016-11-18:
please contact me gligli, I can't leave any message via github. skype: numind06 or mail: dj2jm at hot...com

sorry for disturb.

regards.

gufzzz, 2020-08-19:
Hi gligli, I would be happy to make an update on the user manual, just made an editor un Cubase and would love to get info on the new parameters available. Contact me if you are interested.
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

hotswank, 2020-08-21:
Hi gufzzz, could you tell me/us what CC59 values you used for each LFO mode destination? I'm finding it difficult to pin point each CC value for each combination? When I go from 0-99 with my midi fader I can hear the LFO destination changes and they also repeat themselves after a while but nit exactly. I would like to know which value is what, i.e. Filter, VCO PW, VCO A+B etc. Thanks!

Thread 85 (2016-07-13):

P600 preset mode

ernstfliek, 2016-07-13:
Hi,

Installed the teensy and all seems fine but the preset mode.
In preset mode, whatever preset I choose, say 98, preset 00 shows up.
What could be the problem.

Best regards,

Ernst.

gligli, 2016-07-13:
Hello,

That is because there are no presets stored in the 100 locations.
Just save a patch to any number and then you will ba able to recall it.
Alternatively, you could load the Z80 Presets sysex to have something in all the 100 locations

ernstfliek, 2016-07-13:
Hi,

Thanks, my mistake.

Closed 2016-07-13.

Thread 86 (2016-07-17):

Tuning failures with 3340 Rev G chips

eframp, 2016-07-17:
Now that Curtis/OnChip has re-released the 3340, I've been able to re-populate an otherwise dead Prophet 600 (all the 3340's had been harvested out of it). I've done the resistor swaps as specified in the service manual to bring the tuning trims back toward center.

When using the Z80 scaling routine, I can scale the oscillators perfectly
When using the Z80 Autotune routine, the unit tunes the oscillators perfectly.

When using the GliGli scaline routine, I can get within +/-3 on the display, so it seems to be working fine.
BUT, when using the GliGli AutoTune routine, 11 out of 12 oscillators are tuned incorrectly in the three octaves below Middle-C pitch (as in, if I transpose the oscillators up or down on the keyboard, the scaling is still completely incorrect below the pitch of middle C, not physical middle C on the keyboard). I can't find anything electronically different about the one correctly-scaling oscillator (it's osc. 2B, FWIW).

I've tried two different Teensys flashed with various versions of GliGli (1.0, 2.0, 2.0RC3) and am getting the same results, so I think it's fair to say it's not just GliGli or the Rev G chips, it's the combination of the two. The unit is functioning perfectly (both with Z80 and with GliGli) otherwise.

eframp, 2016-07-21:
Ace Sequential tech Greg Montalbano also had a P-600 with Gligli and a combination of original and Rev G 3340 chips on the bench, and suggested the following workaround. When scaling the instrument, completely ignore both the GliGli and Z80 tuning routines, and set the oscillator trims back to about 12:00 on the dial, as you're looking at them from the keyboard.

It took me a couple of tries, but sure enough, it works.

bad-pritt, 2019-04-28:
Hi, I'm a late Tensi Gligli user, and I'm looking for some help. Here's my problem: first everything went fine but after one day the tuning function sometimes did'nt work (no light, no action), then the two sequencers  and the second arpegiator stoped working. I tryed to update the firmware but the little button on Tensi jumped out ! And the orange light did'nt lite anymore... nowadays the two sequencers works again but I still can't use the two sequencers nor tune my Prophet. (yes, complicated crash story)
Does anyone knows how to solve these bugs please ? Thanks a lot !

Thread 87 (2016-10-16):

CC's not working correctly

MattDiamonds, 2016-10-16:
Hi everybody,

1st of all thanks a lot gligli for your work, it's a huge gift you did for the P600 lovers ;-)

I've got an issue with CC's as it seems to work or notwork depending on the position of original pots on the computer.

Check this video, you'll see that the Cc22 works for Cutoff, then i move the real cutoff pot, and the CC22 doesnt work anymore, then i move the P600's Reso pot and the Cc22(cutoff) works again...

https://youtu.be/A345M8rOyys

Somebody (Gligli?) could help?
May be using Nrpn? Dont'k know how to setup but the Behringer bcr2000 seems to be able to manage nrpn's.

As a last info, i had the exact same issue with an other Cc Controller.

hotswank, 2016-10-16:
This is 'normal' behavior and of technical origin. Nothing to worry about but yes, a little annoying.

Regards,
Maurits

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

Johnnydiamond, 2016-10-16:
Is there an update for the sequencer? My gligli P600 doesn't work.

Sent from my iPhone

On 16 Oct 2016, at 18:07, Maurits Jonkergouw <notifications@github.com<mailto:notifications@github.com>> wrote:

This is 'normal' behavior and of technical origin. Nothing to worry about but yes, a little annoying.

Regards,
Maurits

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

-
You are receiving this because you are subscribed to this thread.
Reply to this email directly, view it on GitHub<https://github.com/gligli/p600fw/issues/87#issuecomment-254059430>, or mute the thread<https://github.com/notifications/unsubscribe-auth/AQftodtnXPJQsVzLu2RrCDqH_0hNIsjwks5q0lnlgaJpZM4KYBKf>.

gligli, 2016-10-16:
It may bave been fixed in 2.1rc3, but I'm not sure, it's been a while since I worked on p600fw code.
2.1rc3 also contains a step sequencer, downloads are there: http://gliglisynth.blogspot.fr/search/label/p600fw

MattDiamonds, 2016-10-16:
@gligli thanks for your quick response, I did install the rc3 before asking ;-) And i'm sad the same issues occurs...

Do you think there's an other solution or i have to abandon the idea of controlling by midi?

My project is to make a 19' Rack of the P600, without keyboard & knobs, for the stage concerts i do. Just to play it in midi with my microkorg XL+ that has lot of custom CC possible to send.

... ;-)

gligli, 2016-10-16:
Now I remember the last tweaked panel pot does parameter changes continuously to avoid stepping that would be caused by change detection. So it's effectively a technical choice.
As long as you don't edit a parameter by both MIDI and panel, it should work fine.

MattDiamonds, 2016-10-19:
Thank you all guys for your replies, specially @gligli for all your efforts building this and remembering all the process to respond ;-)

Take care

MD

Thread 88 (2016-10-24):

Nothing at all happening?

bradholland, 2016-10-24:
Hi there,
I'm a reasonably experienced tech. And have followed instructions to the letter.
The teensy programs just fine, and I have tried two different teensies.
The synth works just fine on the original Z80 but appears dead when the teensie is installed.
The power supply has been recapped.

When I turn the synth on with the teensie installed, its led lights up for about 1-2 seconds then goes off.
Having cut the 5v trace on the teensie and removed the battery, I can program the teensie in situ seems to program fine, but still nothing...

Does this sound like any familiar issue?

thanks in advance for any responses.

bradholland, 2016-10-24:
I should point out, that when I mean dead, the control panel doesnt light up or do anything.

bradholland, 2016-10-29:
moral of the story is, don't by chinese clone teensies...

gligli, 2016-10-29:
Ah yeah true, teensy clones, eg. from EBay don't work with p600fw...

bradholland, 2016-10-29:
it may be that they have an arduino bootloader?

bradholland, 2016-10-29:
in any case, works just great with an original.

gligli, 2016-10-30:
Probably, I use part of the teensy bootloader to save stuff to flash.

Closed 2016-10-29.

Thread 90 (2016-12-19):

VCA Release Issues on p600

blackshapeswhitenoise, 2016-12-19:
Hi Fabrice and forum,

This is most likely more of a hardware problem, but I'm just checking from the software point of view here.

My p600 is experiencing abrupt voltages drops to zero around the end of long envelopes on all six voices. This is most likely also happening on shorter envelope release settings but it is not as noticeable.

Attached are some pictures of oscilloscope readings showing the drop off.

I just want to make sure that it's definitely not an issue with software before I start replacing things like the op amps, demultiplexer, capacitors etc. For example, maybe the hardware and software are working fine, but I might need to make an adjustment on the DAC trim (I have the DAC700 with trim circuit). If it was the computer generated envelopes that were the issue, is it that they just reach a point where they turn off?

Just to clarify, I made these measurements at each voice's S/H circuit after the op amp.

If anyone on the forum has any advice, it would be much appreciated! Thank you!

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

blackshapeswhitenoise, 2016-12-19:
Somehow the photos came out upside down. Sorry!

blackshapeswhitenoise, 2016-12-22:
Just updating here and realizing that you actually acknowledged this issue on a 2.1 alpha post from 2015-2-08, I loaded stable release 2.0 and the issue is no longer there. I just want to let you know that issue is on all the final release candidates and alphas up until 2015-2-08 at which point I just assumed it was on all of them.

Did we ever get a workaround for this that I missed or is it still in the works?

Thank you very much to who have contributed to this fw thus far.

gligli, 2017-01-15:
Hello,
My P600 had the opposite problem, ie envelopes ended too soon and it seemed like there was a range of VCA voltages that just gave a fully closed VCA so I added a small voltage offset to fix this.
Now it seems like your P600 has a "perfect" VCA so that fix has the opposite effect of not fully closing the VCA...
I could compile a 2.1 with that fix removed and it VCA should behave like 2.0.

blackshapeswhitenoise, 2017-01-15:
Thanks for your reply Gligli!

To clarify it seems like my envelopes are closing too soon as well. The upside down pictures might be closing too soon as well, as if the envelopes were ending or being truncated. Sorry if the upside down photos were misleading.

Since I've last posted I was looking into the source code and I'm assuming the offset has something to do with the VCA DEADBAND constant right? I don't really know much about programming, I would definitely love to try a version without the offset as well as one with a different offset.

I also would like to note that when checking my Vdac output voltage the way the service manual recommends by measuring the output of the s/h for Mix A, I am getting 4.92V. Maybe the calibration of the Vdac trimmer is more important and critical with the new firmware?

Happy new year, Gligli! It's nice to hear from you!

Sent from my iPhone

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

gligli, 2017-01-15:
Ah ok, so you have the same problem I had, just worse. In that case, yeah, VCA_DEADBAND needs to be set higher.
If you can get a voltage closer to 5V by adjusting the Vdac trimmer, it should help the whole synth work better, not only the VCA.

Here's a 2.1rc3 version with the VCA_DEADBAND doubled: http://sfx.gligli.free.fr/zik/p600/2_10_rc/2_0992_VCADB/p600firmware.syx

blackshapeswhitenoise, 2017-01-17:
Thanks for the firmware!

It made the voices more uniform with each other, but perhaps made the
release even more abrupt. The release now sounds like a hard cut once it
reaches the end of its envelope.

I will put back the last Alpha back on and try to adjust the VDac trim to
see if it helps.

Thanks for your continuing help!

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

blackshapeswhitenoise, 2017-01-17:
After adjusting the trim on my DAC, I realize that the trimmer only let's
me get as far as 4.93V.

It actually didn't seem to make too much of a difference as far as the
release envelopes went. As such, instead of going closer to 5V I went back
to the service manual recommendation of 4.9V.

The behavior was seemingly the same at 4.9V, 4.92V, and 4.93V so I guess
the service manual is right in stating that it might not be very critical
maybe? Debating whether to keep it at 4.9 or 4.93 currently.

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

gligli, 2017-01-17:
Ok, so you do have the opposite problem I had, which makes sense if the VCA_DEADBAND fix was what made your P600 behave wrongly.

So, this version which has VCA_DEADBAND set to zero should fix the problem: http://sfx.gligli.free.fr/zik/p600/2_10_rc/2_0992_VCADB2/p600firmware.syx

blackshapeswhitenoise, 2017-01-18:
It seems like this has fixed the problem.

I thought at first that maybe each voice was having different release
times/curves, but I let my ears rest and sit awhile while the synth warmed
up and they sound good. I also checked with my oscilloscope and it's
looking good as well!

Here is a photo of fast exponential.

[image: Inline image 1]

So if you put up another final release candidate, or release stable 2.1,
might there be an option to disable, redefine, set the VCA DEADBAND? Just
in case there are more people with the same issue as me or if the feature
wasn't there, for people with a synth like your own?

As always thanks for all your help, I really appreciate it!

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

rundgrenrules, 2021-08-29:
Does anyone happen to have either of these DEADBAND adjusted firmware files available?  I have had the same issue across all revs of the firmware and would LOVE to fix it!

Thread 91 (2017-01-15):

Reinstall the vanilla sequencer?

loreschi, 2017-01-15:
Hi there, thanks for the great job!
Is there any way to have the standard P600 real time sequencer back?
I feel it was much more immediate and muscial than inserting rests/ties etc. (plus, I believe that the P6 itself now has a similar real time sequencer).
Could you do an update with all of the upgrades BUT with the old sequencer? : )

P.S. I've donated, posted on gliglisynth & gearslutz. Let's try to raise the request here on github!
For the time being, Thanks again for your amazing work!

gligli, 2017-01-15:
Hello, thanks!
I can't use any of the functionnality / code of the original firmware directly, I have to rewrite it entirely.
So, developing a realtime sequencer is doable, but it's something that requires quite a lot of time.
I personally thought a step sequencer would be more useful for electronic music / loops and used it for this with no problem.

Thread 92 (2017-01-22):

Ploblems after failed upgrade

prohet13, 2017-01-22:
Hi folks, as the teensy board (https://www.pjrc.com/store/teensypp_pins.html) is out of stock I just ordered one on ebay where I had to solder the pins by myself onto the board. After I had done this I followed exactly the steps from gliglis document but with no result. The p600 didn´t work after I finished my work which is caused by my bad solder skills I guess (looks really terrible). However, I dicided to go on with the original cpu and come back later with an new, pre solderd teensy. So here is my problem:  when I put back the z80 into the socket and powered on the p600 there was nothing on the display. I tried once again and again.. sometimes appeared a permanent noise and some undefined symbols, sometimes it happend nothing -.-
No button or poti shows any reaticon as well.

May I destroyed the solder joints from the socket when I first removed the z80 (it was really hard to get it out) ? Or is there just any procedur to re setup the p600 after removing the cpu ?

I would be really happy for some help cause I have no idea what to do now with my lovely p600 :( :(

Thanks and kind Regards

gligli, 2017-01-22:
Hello,
It's hard to tell what's wrong but teensys from EBay are often chinese clones and don't work with p600fw.
Going back to the Z80 should just work, not additional procedure.
I'd say double check your soldering on the teensy, if everything was correct, then yeah, the Z80 not working was probably a dry solder joint or a Z80 socket bad contact, something like that...

prohet13, 2017-01-22:
Hi, thanks for the fast reply !

I found the problem: because of the bad prepared teensy there were two contacts from the socket bent so they had no contact anymore to the z80 anymore. Now I fixed this and the synth is working.. glad that there are no problems with solder joints on the card..

The teensy I orderd is this one: http://www.ebay.de/itm/322139808714?_trksid=p2060353.m2749.l2649&ssPageName=STRK%3AMEBIDX%3AIT

Maybe it didn´t work because this teensy is bad but I am almost sure that I destroyed some contacts on the board as well while treating it with very bad equiptment and no skills *grrr*

Is there any option to get an pre soldered teensy ? At least with pre soldered pins ? Or do you have any idea how long it takes until the stock from pjrc.com is refilled?

Thanks for your help !! Kind Regards

gligli, 2017-01-23:
Ok, good!

Looks like a genuine one from the pics. I think so far all teensy clones I heard of had a blue led instead of orange.

No idead about PJRC stocks, but I think you can get teensys from EU shops, look at this thread on pjrc.com: https://forum.pjrc.com/threads/23601-Official-Distributors.

Winbyte, 2017-01-24:
MY first teensy was from china  and it did not even take the Flash from the teensy loader!

prohet13, 2017-01-25:
I finally got a new teensy from Watterott Electronics and with some new solder equipment I made the upgrade successful :) Thanks for your help and for your awesome work in general !! I am really excited about the new power the synth provides now :+1:

prohet13, 2017-01-25:
One more question I have :

 with the numerical values from the display I see that the bender isn´t in zero position when it latch into the middle of the track. I also had problems before when I tried to do the tuning right with some other synths.. now I know where it comes from.. So do you maybe heard of this issue ? I think its just a problem caused by the hardware ?! Can I just fix it by turning some screws ?

gligli, 2017-01-25:
Cool, good to head it finally works!
You can calibrate the bender by letting it in the center and pressing FROM TAPE + 3.

prohet13, 2017-01-25:
I really should read the manuel carfeully before asking stupid questions :D now it works perfect! Thanks a lot !

jxalex, 2017-01-29:
I got the similar problem. With Z80 the synth works, with teensy not. but I have very fine good soldering. After I put the Z80 back, the synth still works.
The installation manual is no help, becouse it was rather meant for those who know barely know which end is hot on a soldering iron.

Where is the all hardware debuging or troubleshooting information?
And can someone explain now whats the trouble why it does not work with e-bay chinese clone teensies?

So where from to start the check? (yes, the +5V arrives to the board).

It would help if atleast there would be some SERVICE MODE or troubleshooting or TEST mode in your firmware. Is it?!

hotswank, 2017-01-29:
Hi, it does not work with China Teensy clones because they are China Teensy clones!!!

Hope that helps.
________________________________
Van: jxalex<mailto:notifications@github.com>
Verzonden: ‎29-‎1-‎2017 10:17
Aan: gligli/p600fw<mailto:p600fw@noreply.github.com>
CC: Subscribed<mailto:subscribed@noreply.github.com>
Onderwerp: Re: [gligli/p600fw] Problems after failed upgrade (#92)

I got the similar problem. With Z80 the synth works, with teensy not. but I have very fine good soldering. After I put the Z80 back, the synth still works.
The installation manual is no help, becouse it was rather meant for those who know barely know which end is hot on a soldering iron.

Where is the all hardware debuging or troubleshooting information?
And can someone explain now whats the trouble why it does not work with e-bay chinese clone teensies?

So where from to start the check? (yes, the +5V arrives to the board).

It would help if atleast there would be some SERVICE MODE or troubleshooting or TEST mode in your firmware. Is it?!

—
You are receiving this because you are subscribed to this thread.
Reply to this email directly, view it on GitHub<https://github.com/gligli/p600fw/issues/92#issuecomment-275902570>, or mute the thread<https://github.com/notifications/unsubscribe-auth/AKu6JcBUMtK8Cp9oysQ4DSPW4mfKxaGGks5rXFkmgaJpZM4LqXsZ>.

gligli, 2017-01-29:
It does not work with teensy clones because the bootloader is different and p600fw depends on an undocumented behavior of the official PJRC bootloader to be able to write flash.

If the soldering is correct and it's an official teensy properly flashed with p600fw, it should at least boot and display something.

The firmware can be compiled in DEBUG mode, which will use USB to log stuff but there was never a need for a SERVICE mode.

jxalex, 2017-01-29:
So,  You are using other peoples brainpower but you still drain huge money as you make secrecy of some source code? But this is ridiculous!! This is NOT opensource.

I would have contributed too after I had got running my P600 as I develop also tweaks for other synthesizers as well. I think I will better use Z80 and dont bother about it if you are with such attitude!

jxalex, 2017-01-29:
why I should ever ever consider contributing some work or coding, debuging, if you charge $150 for some kit?!??

gligli, 2017-01-29:
That's not what I said. So you seem to be able to understand code, here's the code that uses the teensy bootloader: https://github.com/gligli/p600fw/blob/master/firmware/teensy_bootloader_hack.h
As you can see, it's not like I had a choice if I wanted to be able to program the teensy flash.

It's clearly mentionned everywhere that this project is based on a $27 teensy++ chip, I get not a single dollar from PJRC.

Also, I'm totally fine with you not using p600fw, and not contributing anything.

Thread 94 (2017-02-12):

Error message after everything working fine

AGP84, 2017-02-12:
Hi, I have been using my P600 for the last year with GliGli upgrade without any problems, then one day (after using it the previous day without problem) when turning it on behaved strangely - at first one of the voices seemed to be out of tune but the tuning routine didnt help, and a few cycles of turning off/on ended with it making odd noises and no musical sounds.  I also tried the tuning routine a few times which seemed to be taking longer to complete but didnt solve the problem.  The orange light on the teensy still glowing as normal.  I noticed when the problem started, on powering up the display was scrolling an error message which I think is Uer 2,0992 (it may be 2,092).  I'm pretty sure it didnt display this message before the problem occurred.
Then, after a couple of days not using it, I turned it back on and the error message is still there but everything seems to be working normally - all of my sounds are there and everything in tune, functions all seem to be working, this is great but very concerned by the error message and if it's going to become non-musical again!  I havent been able to find any reference to the error message and what it might mean, do you have any ideas please?

gligli, 2017-02-12:
Hello!
The message is "Ver 2.0992", it's just the firmware version number, it's not an error message :)
The actual problem could be a dry solder joint or a connector / chip socket not making proper contact I think...

AGP84, 2017-02-13:
Thats great news I'll just keep an eye on it and check chip sockets etc if it happens again thank you very much!

Closed 2017-02-13.

Thread 96 (2017-02-20):

Gligli firmware starts up then no response

slowpilgrim1, 2017-02-20:
Hi there,

I just bought my Prophet 600, which came with a Teensy board but the previous owner had chosen not to install it. I was told the firmware had already been uploaded on to the chip, and if I wanted to use it I just needed to install into the synth.

When I insert the chip and switch the synth on, the LED does not light on the board but the synth itself reads the welcome message and indicates ver 2.00. After this, the message disappears and the synth behaves as it if was switched off - no readout, no sound, and the control panel is unresponsive. When I put the Z80 back in, the synth works fine again.

I tried re-flashing the Teensy but it will not talk with any of my PCs, and the LED will not light up even after I tried to put it in Manual Program mode. I don't know anything about electronics or programming, but assume it's not receiving power for some reason. It's odd that it will at least display the welcome message on the synth though.

I don't know if it's related, but the previous owner mentioned that he thought the synth itself was faulty because the sound becomes mangled sometimes with the Z80 in. It also wiped nearly all of his patches, and replaced them all with the same patch which just makes high resonance sounds.

Since I've been playing with it, I've experienced no issues - I can program new patches fine, and they save correctly, and I can overwrite his 'faulty patches'. This makes me think the issue he had was something to do with trying to install the Teensy.

Sorry if this all sounds vague, but I've had it for one day and am not good at trouble shooting. Have you got some ideas on how I can begin to identify and solve the problem?

Thanks for your time,

Ash

slowpilgrim1, 2017-02-20:
board is Teensy++ and appears to be genuine

gligli, 2017-02-20:
Hello,
Try putting the synth in update mode by pressing FROM TAPE + TO TAPE while powering the synth.
If it displays "U", then you could try uploading this version: http://gliglisynth.blogspot.fr/2015/09/p600fw-210-third-release-candidate.html though MIDI sysex. (This is better explained in version 2.0 user manual)

slowpilgrim1, 2017-02-22:
Hi, thanks for the response. I bought an M audio midisport uno and tried that with no luck. I put the synth in upgrade mode as you said, get the 'U', but the moment I connect the MIDI in cable from the M audio to the MIDI in on the synth and run Sysex, I get an E the moment I send. I've tried increasing the delay between buffers to 300ms and also the Input/Output buffer size to 1024 bytes with no luck, always the E.

Is there anything else I can try? Perhaps I need a better MIDI interface, or to reflash the teensy via usb?

Thanks.

gligli, 2017-02-22:
Hmm, I think it seems like a proper midi interface but make sure it's not sending MIDI clock or any other stuff while you send the sysex. The updater has a really basic MIDI parser which would error when receiving that.

slowpilgrim1, 2017-02-26:
Hi, thanks for the reply! I checked and it's not sending MIDI clock or anything else from what I can see.

I tried updating using snoize on my Mac instead of MIDI-OX on my windows desktop and still got the error. However, despite the manual advising not to, I've tried switching it on and now I at least get:

A) welcome msg
B) preset numbers displaying in preset mode
C) jumbled characters which are scrambled when I enter manual mode
D) Parameter names will display correctly on the screen when you key in different settings (but flicker occasionally)

As soon as I hit a key on the keyboard, the screen goes blank and the unit is practically 'switched off' again.

Weird.

felixp600, 2017-03-22:
Hi!  I had the exact problem that Teensy++ 2.0 switched off as soon as I press the key on the keyboard after the welcome message.  And it seemed like that was a bad connection between one of the pins & a CUP socket.

I found that out since the pins on my Teensy++ 2.0 board (purchased directly from PJRC) are too thick to fit into the original Z80 socket!  I pushed it sooo hard, but at one point I thought I'm going to break something, so I decided to solder the board on an extra CPU socket that I had which has small pins.  Then mounted that board + extra socket onto the P600.

It worked fine in the beginning, but suddenly I found it gets switched off.  So I re-soldered the pins again, and it came back.  And once I had to remove this board + socket to check something else, and re-mounted them.  Then the same thing happened again, and I re-soldered the pins, and it's all fine again!

Although MIDI sync doesn't work on mine (other MIDI function works OK so far)...  which I'm currently trying to figure it out.

Hope this helps a little...

Thread 98 (2017-08-08):

Help, Gligli firmware upgrade

syntomik, 2017-08-08:
Please help,  pressing "from tape" + "to tape" the "U" appears on the display but when I send the syx file from midiox nothing happens. The syx file is sending but the P600 always shows "U". I'm using a db15-midi cable from the sound card to midi on the P600 ( I don't have a USB-midi cable). Could this be a setting issue in midiox or some other problem? Not sure where to go from here, any help appreciated. thx

hotswank, 2017-08-08:
Have you verified the sound card/midi cable can succesfully send any sysex data to any of your other synths?

syntomik, 2017-08-08:
Naturally, that's the first thing I tried. I successfully transmitted sysex to Siel DK600 using the same method. So, I'm wondering if P600 is waiting for data on the midi in or not? anything else I can check?

syntomik, 2017-08-09:
update: I went out to purchase a USB-Midi interface, installed it, drivers loaded. Still nothing from the P600. Actually, most of the time it stays on "U" but sometimes I get "E". I configured the timing buffers to 250ms like the manual says but still nothing. Still no problems sending sysex to my Siel. Does anyone know what's going on, why I can't upgrade the firmware? Am I overlooking something or setting?
I tried both p600firmware and p600fw_stable_2.0, no difference
Any suggestions, anyone?

hotswank, 2017-08-09:
Do you have a genuine Teensy board and not a China clone from eBay? Does your current P600 firmware respond to MIDI CC and NOTE on/off correctly? What is your current firmware version and why do you need/want to flash it? Can you succesfully dump a sysex to MIDIOX:
"Miscellaneous Settings function “6” will send a SysEx dump of all presets on MIDI out. Use your favourite SysEx utility to store it."  http://www.midiox.com/cgi-bin/yabb/YaBB.pl?board=query;action=display;num=1424865245  HTH

syntomik, 2017-08-09:
Yes, I have a genuine teensy with orange led. I'm just following the manual so I flashed the teensy with the hex file, it booted , got the scrolling message and went thru its calibration. Next step, upgrade the firmware, this is where I'm/teensy is stuck.  P600 eprom is six-0-8, I can't seem to upgrade the teensy firmware? I'm not dumping to PC

syntomik, 2017-08-10:
So, re-installing the Z80 and checking midi in/out data with midiox works flawlessly without issues, midi in/out connections are good from p600 to pc, even re-loaded the factory patches without problems.
So my problem lies within the teensy ++ 2.0
I will start over with the connections and re-flash the teensy and go from there.
thank you all for your suggestions!

elauria, 2019-03-18:
I know you successfully sent sysex to your Siel, but I'm gonna say this anyways: is the "pass sysex" option in midiox enabled? (Options -> Pass Sysex). I missed this one and was struggling to understand why it wasn't working.

Thread 99 (2017-08-09):

Arpeggiator stopped working

Retrofuturist, 2017-08-09:
I did the upgrade a few months ago and it has been great.  My arpeggiator was working just fine up until a few days ago when it just completely stopped.  I turn it on and I get no sound from any keys, dead silence from all voices.  Doesnt matter which arp pattern i use, dead silence when the button is active.  Switch it off and the voices are back.  Not sure which version of firmware in using, I'll check later today.

braincloudsound, 2017-12-13:
I'm having the same issue.  Did you find a solution?

amichaela23, 2017-12-18:
Anything come of this? I just got this thing got one and update the OS to the 2.1 to get the sequencer to work and now neither is working!

braincloudsound, 2017-12-18:
Not yet. I just ordered a z80 processor chip on the advice of a tech. Since my prophet 600 still has the original rom/ram chips installed, apparently I can remove the gligli update and replace the z80 and it should function as it did originally. If at that point the arpeggiator still doesn’t work, then the problem isn’t with the gligli. It’s a separate issue that will need to be addressed. If it DOES work however, then it’s likely my gligli chip is faulty and I will try reflashing the OS and trying it again.

braincloudsound, 2017-12-18:
Not yet. I just ordered a z80 processor chip on the advice of a tech. Since my prophet 600 still has the original rom/ram chips installed, apparently I can remove the gligli update and replace the z80 and it should function as it did originally. If at that point the arpeggiator still doesn’t work, then the problem isn’t with the gligli. It’s a separate issue that will need to be addressed. If it DOES work however, then it’s likely my gligli chip is faulty and I will try reflashing the OS and trying it again.

Sent from my iPhone

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

amichaela23, 2017-12-18:
Ugh, I just bought this thing and the arpeggiator went up when I did this OS update, trying to get the sequencer to work. My tech is gonna be mad at me probaby for buying it with the gligli update haha.

amichaela23, 2017-12-18:
How do yo u"reflash" the OS?

braincloudsound, 2017-12-18:
Yeah, mine was a new purchase. Should have demoed the arpeggiator before I left.

Anyway, I don’t know how to reflash the os myself. But basically, there is a USB port on the gligli chip which is how the os is loaded and I would have my tech reload the os onto it again just to make sure it’s fully functional or replace the chip completely with another gligli chip. There is a guy who goes by synthchaser in San Diego who is helping troubleshoot this with me.

Sent from my iPhone

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

amichaela23, 2017-12-18:
Might be worth a drive to Sand Diego cause I'm really scared my keyboard tech is gonna get mad at me cause I bought it without talking to him first, haha.

braincloudsound, 2017-12-18:
Yeah, I’m in LA. Weird we are nothing having similar problems. Other than the seq and arp issue, I love the upgrade. The faster envelopes and dual vco levels that can drive the filter are enough to make it worth it Aline. But I was really looking forward to the arp.

I’m waiting on the z80 from China. Mistakingly bought one before checking the vendor so it will likely be a week or so before I can deal with it.

The guy in San Diego told me he comes up to pick up drop off every so often so it might all work out if you’re not in a huge hurry

Scot
323-823-2031

Sent from my iPhone

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

Retrofuturist, 2017-12-18:
My arp still isn't working.  I don't want to revert to the Z80 because I have several great patches that I programmed with the new chip that I don't want to lose.  Did either of you have success refreshing the OS?

amichaela23, 2017-12-18:
No luck, I’m taking it in to a tech today. Did you update to the 2.1.1? Did your arp ever work with 2.0?

There’s always tape!! :)

braincloudsound, 2017-12-18:
no, I literally have only owned it for 6 days.  I got it with the Gligli installed and it says 2.0 on boot up.
I hope the Z80 chip gets here this week so I can swap it out and see if it works in the original state.
If not, I’m unsure whether that is something easy to fix, or if it would be too expensive to troubleshoot.

But let me know what your tech says.  Could be helpful to narrow down the trouble spot on my p600.

Scot Lang
(323) 823-2031
www.braincloudsound.com <http://www.braincloudsound.com/>
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

amichaela23, 2017-12-19:
Okay, I dropped in a z80 and the arpeggiator works. My panel needs to be replaced for the sequencer to work. The tech I went to is not a fan of the gligli but I also inhabit a more traditional music world. I’m keeping the z80 getting the panel replaced and keeping it OG. I wanted a John carpenter machine basically.

amichaela23, 2017-12-19:
Also got to borrow the original owners manual which is pretty Stoney

phawsea, 2017-12-29:
I think I do have the same issue. The arp should work as soon as I hit one of the two arp buttons shouldn't it? As I can see when starting up I should have version 2.099 installed (I didn't do it myself).

braincloudsound, 2017-12-29:
Yes, it should. I’m still waiting on a z80 chip so I can restore the p600 to its standard operation to see if the arp and seq start working again. Seems you are the 4th person with a similar problem. Seems that some gligli updates are problematic. I bought my p600 with the upgrade preinstalled so I’m not certain who supplied the update but it’s possible these are all from a bad batch.
Fortunately there is a guy near me who sells the upgrade and if the z80 swap does the trick, I might be able to get the upgrade from him with a money back guarantee if his os doesn’t work. Will update soon.

Sent from my iPhone

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

Retrofuturist, 2017-12-29:
I built my chip from scratch and flashed it myself, so maybe the firmware version I'm using is unstable.

amichaela23, 2017-12-29:
I still need mine serviced to get the seq to work. I’m really digging the sounds with the Z80 tho. I don’t really have a gligli relationship cause I took it right in.

Are the sounds different?

jhhl, 2017-12-29:
GliGli's mod greatly expands the capabilities fo the old P600. The oscillators and filters are still analog, but the digitally created envelope generators, LFOs, and MIDI controls have been much improved! The Arpeggiator is also different from the original, and there's a step sequencer that I don't like very much.

I'd give more advice, but my P600 us unwell, unrelated to GliGli issues.

braincloudsound, 2018-01-13:
A little update for those interested. I reverted to the Z80 chip and everything started working again.  I asked a tech about a possible problem with the Gligli update itself, and he explained there was a version where the arp and seq functionality was removed because he needed the memory for other functions, but was supposed to put it back (and it was) in a later version.  I can't confirm which version since I removed the update, but I am looking to have it flashed and updated to the latest (working) version with arp and seq functionality.  If anyone can confirm which version this is.  Thanks

Thread 100 (2017-11-06):

Not booting ?

otite, 2017-11-06:
hello,

i just changed the z80 for the teensy, but when i switch the p600 on, nothing happen.
any clue ? my soldering looks good...

g

gligli, 2017-11-06:
Hi,
Hmm, hard to tell like that, did you flash the teensy before putting it in?
Also maybe check the wire for pin 30 on the socket isn't touching what's left of the pin on the teensy...

otite, 2017-11-06:
hi,
yes i flashed the teensy, i tested it with a basic hello world program and seems fine.
i bought a teensy without pins so i just put no pin on 30, so that can't be that.

i'll try with another teensy and let you know, maybe this one has a problem.

Thread 102 (2018-02-17):

Dump and Load Sysex

suburbanimal, 2018-02-17:
I used Snoize's Sysex Librarian to dump my patches and load them in another P600.
Both have a Teensy with 2.0 stable version.

The sysex dumps from both synths are 131 bytes which is odd knowing that could be hold the content of a single presets data.
In order to receive the data I put the P600 receive channel on Omni.

Have I missed something or this dump functionality isn't working?

In case that helps, here's the Hexadecimal data contained in the sysex file from the dump
F0006116 01002516 61020003 002F0000 7240070E 40170073 097F7F00 33094004 000F0100 37000303 0068003D 08007300 03020044 00000200 03400304 40770000 01000070 46007F7F 00000101 01000100 00000000 00010000 00000201 00010000 01000500 01010200 00007F7F 00020070 037F0A7F 00000000 7F7F7F7F 0F7F0000 0001F7

Merci ;)
Vincent

hotswank, 2018-04-05:
Have you solved this issue and how?

Closed 2018-02-27.

Thread 108 (2018-09-25):

Intermittent, temporary craziness

suburbanbeat, 2018-09-25:
Hey, I just finished the GliGli upgrade this weekend. It's fantastic. Thank you for all of the hard work that you put into the project.

I must have made a poor connection, but I'm not sure which one it is. Every so often, at seemingly random times, my Prophet 600 will go generally crazy for about 2-10 seconds. The LED flickers nonsense, any notes that I was playing at the time hang for a while, and the tuning gets real wonky on the notes that are hanging. After a few seconds it's resolved and the P600 plays normally.

I re-did some of the soldier points that didn't look totally clean, but still the problem persists. Is it the wire going to the Prophet that is the issue?

Thanks in advance.

Thread 114 (2020-08-04):

Very Slow Arpeggiator

mrecirc, 2020-08-04:
Hello!
I’m working with a client’s Prophet 600 with a newly installed Gligli CPU. He purchased it from someone who already loaded it and modified the Teensy board. Everything seems to work okay, except for the arpeggiator speed. When synced to MIDI, or receiving pulses through the Tape In, it runs super slow. Also, the Speed pot does not seem to have an affect when it’s set for Internal clocking, even though I see the values change on the LED display.

I reinstalled the original Z80, and the Speed control works fine. I can also send a pulse through the Footswitch In, and the tempo is what I would expect. With the Gligli installed, I have to send a pulse over 1K, or a MIDI BPM (from Ableton) over 500 to have a similar tempo. I don’t have exact numbers, so I hope that makes sense!

It’s still running the original OS from 1982. Six-0-2-1. Could that be an issue when running with the new CPU?

I appreciate any help, and I hope I posted this to the right place!

Thanks,
Mike

Thread 115 (2020-08-12):

Would it be possible to have 1/4 step filter cv values when Keyboard tracking is set to 1/2?

dphelmer, 2020-08-12:
Currently when using no VCO and playing the self-oscillating filter with the tracking set to 1/2 you still get all half step note values. It would be very cool to get 1/4 step filter cv values for some microtonal type playing.

image-et-son, 2022-08-14:
Hi, sorry. this is a VERY late response. I'd propose that you post this as a change request "issue" in the v2022 development branch, here: https://github.com/image-et-son/p600fw/issues

Things to come will need to prioritized, but I think this is a valid, viable and technically minor change, so good chance.

Thread 117 (2023-02-04):

Do i have a dud?!

TheRaydevil, 2023-02-04:
Hey everyone, My nice GliGli upgrade is unfortunately not going as planned... Bought a Teensy++2.0 from Tinkesphere, Prepped it as per instructions, loaded the 2.0V hex file, installed it... power on and... Nothing. Took it out again and made sure to check everything top to bottom, over and over. Everything in order. re-loaded the file a couple of time... still nothing. Finally Decided to try loading it with Imogens version 2.1, Re-installed it, power on and now i have the tuning sequence starting but crashes right after going thru the filters leaving the number 6 on the display. It just freezes like that. Tried over and over, even the GliGlis 2.0V one last time. Nothing.

I can only get it to "power up" with Imogens version but then of course it freezes. Any other version will do nothing. If i put the original Z80 back in everything works normal. I sort of lost now... Any ideas?

matrix12x, 2023-02-04:
Did you correctly do the mods to the teensy? carefully go over to make sure the solder joints look good.

Also,  if you got a teensy clone, it probably will not work. The bootloader on the clone is wrong and the Gligli software relies on the bootloader.

TheRaydevil, 2023-02-05:
Thanks for the reply! I've gone through everything over and over. Everything looks fine. Joints are nice, everything is routed correctly. I got the Teensy board from Tinkersphere (actually followed the link posted directly on the PJRC website) so i'm hoping i didnt get a clone. LED is Orange... as i read most clones are various other colours.
Strange thing is that if i load any other versions other than the Imogens 2.1 the LED stops working. If i plug it back to the computer i get nothing. no blinking... Same when i put it in the Synth. Dead... nothing.

image-et-son, 2023-02-06:
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

Do you mean this link? Even though it's been linked from PJRC, I am not convinced that these are actually original PJRC boards. Why can you preorder them? They've out of production for a long time. Sounds very strange.

And I agrre, it is most likely that you are working on a board with a bootloader that is different from the one PJRC is using. In that case, the firmware does not work.

I am still working on making the firmware work on other boards, but the outcome is totally open.

TheRaydevil, 2023-02-06:
Yup!! That would be the one. That "Pre-order" thing is new i guess. When i bought mine they had a couple in stock. I was stoked to have found some and was pretty excited to receive it and start the project but now i see THIS... Which totally makes me think that the one i received is a stupid knock off.... 100$ Canadian including shipping for this...

TheRaydevil, 2023-03-19:
I wrote to Tinkershere asking about that actually. Their answer was to "test the board" by trying the Slow blink Fast blink hex files to make sure my unit wasn't defective. (which i did and everything turned out fine) But they did answer the "being a clone" question.

TheRaydevil, 2023-03-19:
And i see now they they (Tinkersphere) has them back in stock now... So we most certainly know now that these are indeed clones

Midphase, 2025-08-29:
Genuine Teensy 2.0 ++ have become unobtanium in 2025. Any possibility of making this work with counterfeit clones since that's all that is available? I too am getting stuck after the tuning routine where the display only reads 6 (or is it supposed to be G from the welcome scroll?).

Anyways, any help is much appreciated here, at the moment I fear that without a solution to run this mod on a counterfeit clone, or alternatively to port it to a newer Teensy, the GliGli Prophet 600 mod is effectively dead.

matrix12x, 2025-08-29:
Are you running this version:
https://www.image-et-son.com/

Also, some P600s have a mux chip that over time is slow and sometimes leads to these tuning issues.
https://prophet600revisited.blogspot.com/2022/06/feedback-on-2022-beta-watch-your.html

Midphase, 2025-08-29:
Yes, I tried it both with the latest GliGli Stable 2.0 and the latest Imogen 2022_1, on the GliGli nothing happens, like no display no nothing. On the Imogen version it goes through the Tuning Routine, after it finishes that, a "6" appears on the display and the unit is effectively frozen. If I hit the Tape In/Out buttons I can get it to go into Update mode, but beyond that nothing happens.

I did read the blog about the 4051's and this unit has the original factory TI 4051BE multiplexers...

Any other ideas? Does the EPROM Firmware revision matter?

Midphase, 2025-09-09:
Any updates?

Midphase, 2025-09-17:
What about the idea of completely porting to a non-Teensy solution like it has been posted on GearSpace? Would that turn out to be a less demanding solution with ultimately more longevity?  https://gearspace.com/board/electronic-music-instruments-and-electronic-music-production/845271-prophet-600-users-have-upgrade-144.html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

image-et-son, 2025-09-17:
@gligli : have you ever used USB storage with the Teensy? There are functions for this but I could never get it to work (probably my fault). It just sounds like an easy way. Having said that, I didn't even know there's an eeprom...

Colpocorto, 2025-09-18:
> [@gligli](https://github.com/gligli) : have you ever used USB storage with the Teensy? There are functions for this but I could never get it to work (probably my fault). It just sounds like an easy way. Having said that, I didn't even know there's an eeprom...

Better let's drop the Teensy forever.

We neee a PJRC-free solution.

Thread 118 (2024-12-18):

booting stops with "F"

mpuetsch, 2024-12-18:
Hallo ,
-when I flash the firmware versions
p600firmware_beta_1_0
and
P600_firmware_v2022_1
on the teensy xx2, the Prophet start runs as described:
The orange LED on the Teensy will light and the tune routine will commence stepping
through the 12 oscillators and 6 filters; during the tune routine the display cycle A1 through A6, b1 through b6 and F1 through F6.
**but** instead of: "After approximately 20-30 seconds, a welcome message will scroll."
**it comes: "F"**

-when I flash the firmware versions
p600firmware V2_10 RC3 from_gligli_Rep_2015-09-05
and
p600firmware_stable_2_0
the prophets doesn´t boot at all.

has someone an idea for this?
what I´m doing wrong?
thank you soo much
Geo from Cologne Germany

hotswank, 2024-12-20:
I'm not an expert but it's common sense to check your power supply and replace caps of your P600. Those puppies are getting very old you know and chances are it's something hardware related. Good luck and I hope you will sort it out!

gligli, 2025-09-18:
This is basically the same as issue #117
Teensy++ 2.0 that are available nowadays don't have the same bootloader as the original PJRC's and that's why it crashes just after the tuning procedure.
In any case, I'm trying to devise a fix.

mpuetsch, 2025-09-18:
Thank you so muchVon meinem iPhone gesendetAm 18.09.2025 um 15:11 schrieb GliGli ***@***.***>: gligli left a comment (gligli/p600fw#118)
This is basically the same as issue #117
Teensy++ 2.0 that are available nowadays don't have the same bootloader as the original PJRC's and that's why it crashes just after the tuning procedure.
In any case, I'm trying to devise a fix.

—Reply to this email directly, view it on GitHub, or unsubscribe.You are receiving this because you authored the thread.Message ID: ***@***.***>
