gligli/p600fw/common/adsr_lookups.h

#ifndef ADSR_TABLES_H
#define	ADSR_TABLES_H

#include "synth.h"

const uint16_t attackCurveLookup[]=
{
	0,494,986,1475,1961,2444,2924,3402,3877,4349,4818,5284,5748,6209,6667,7123,
	7576,8026,8474,8919,9361,9801,10238,10673,11105,11534,11961,12386,12808,
	13227,13645,14059,14471,14881,15289,15694,16096,16497,16894,17290,17683,
	18074,18463,18849,19234,19615,19995,20372,20748,21121,21492,21860,22227,
	22591,22953,23313,23671,24027,24381,24732,25082,25430,25775,26119,26460,
	26800,27137,27473,27806,28138,28468,28795,29121,29445,29767,30087,30405,
	30722,31036,31349,31660,31969,32276,32581,32885,33187,33487,33785,34081,
	34376,34669,34961,35250,35538,35825,36109,36392,36673,36953,37231,37507,
	37782,38055,38326,38596,38865,39131,39397,39660,39922,40183,40442,40699,
	40955,41210,41463,41714,41964,42213,42460,42706,42950,43193,43434,43674,
	43912,44150,44385,44620,44853,45084,45315,45543,45771,45997,46222,46446,
	46668,46889,47109,47327,47544,47760,47975,48188,48400,48611,48820,49029,
	49236,49442,49646,49850,50052,50253,50453,50652,50850,51046,51241,51436,
	51629,51821,52011,52201,52389,52577,52763,52948,53133,53316,53498,53679,
	53858,54037,54215,54392,54567,54742,54916,55088,55260,55430,55600,55769,
	55936,56103,56268,56433,56597,56759,56921,57082,57242,57401,57559,57716,
	57872,58028,58182,58335,58488,58640,58790,58940,59089,59237,59385,59531,
	59676,59821,59965,60108,60250,60391,60532,60672,60810,60948,61086,61222,
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
    0x8D,0x87,0x82,0x7D,0x78,0x73,0x6F,0x6A,0x66,0x62,0x5E,
    0x5A,0x57,0x53,0x50,0x4D,0x4A,0x47,0x44,0x41,0x3F,0x3C,
    0x3A,0x38,0x35,0x33,0x31,0x2F,0x2D,0x2C,0x2A,0x28,0x27,
    0x25,0x24,0x22,0x21,0x1F,0x1E,0x1D,
};
			
#endif	/* ADSR_TABLES_H */
