gligli/p600fw/common/arp.h

#ifndef ARP_H
#define	ARP_H

#include "synth.h"

typedef enum
{
	amOff=0,amUpDown=1,amRandom=2,amAssign=3
} arpMode_t;


void arp_init(void);
void arp_update(void);

void arp_setMode(arpMode_t mode, int8_t hold);
void arp_setSpeed(uint16_t speed);
void arp_setTranspose(int8_t transpose);
arpMode_t arp_getMode(void);
int8_t arp_getHold(void);
void arp_resetCounter(int8_t beatReset);

void arp_assignNote(uint8_t note, int8_t on);

#endif	/* ARP_H */
