gligli/p600fw/common/dac.c

////////////////////////////////////////////////////////////////////////////////
// DAC chip
////////////////////////////////////////////////////////////////////////////////

#include "dac.h"

NOINLINE void dac_write(uint16_t value)
{
	mem_write(0x4001,value>>10);
	mem_write(0x4000,value>>2);
}
