gligli/p600fw/(commit log)

2013-02-10 mockup: working potentiometer scanner/multiplexer / addes hardware abstraction header / misc fixes emulator: better pot mux emulation
    [hardware.h, p600.c, p600.h, potmux.c, potmux.h, scanner.c, synth.c]
2013-02-11 misc fixes / envelopes WIP
    [adsr.c, adsr.h, adsr_lookups.h, display.c, p600.c, potmux.c]
2013-02-11 envelopes working on hardware / "wired" everything as a monophonic synth for now
2013-02-12 interrupt based envelopes / ints are now blocked while talking to HW
2013-02-13 adsr rework for speed and accuracy / now handle 12 concurrent envs / misc changes
    [adsr.c, adsr.h, p600.c, p600.h, p600firmware.c]
2013-02-15 adsr: now using 16bit tables for expo curves / rework for speed an accuracy (no audible stepping on resonance zaps now)
    [adsr.c, adsr.h, adsr_lookups.h]
2013-02-16 adding tuning code / build fix
    [hardware.h, hardware_impl.h, p600.c, p600.h, p600firmware.c, synth.c, tuner.c, tuner.h]
2013-02-17 manual code inlining (lowers code size) / DAC fix
    [adsr.c, dac.c, p600.c, p600firmware.c, potmux.c, scanner.c, synth.c, tuner.c]
2013-02-18 voice assigner / tuner rework for accuracy and speed / low level optimisations / refactorings
    [adsr.c, adsr.h, assigner.c, assigner.h, dac.c, display.c, hardware.h, hardware_impl.h]
2013-02-18 oops! (fixing a bus conflict)
    [p600firmware.c]
2013-02-19 adding working LFO / refactoring / misc fixes
    [adsr.c, adsr.h, lfo.c, lfo.h, p600.c, p600.h, p600firmware.c, tuner.c]
2013-02-21 faster keyboard scan (500hz now)
2013-02-21 keyboard scanner rework (faster / hopefully less glitchy)
    [scanner.c]
2013-02-22 assigned: major rework / unison and mono are now legato, high or lo priority
    [assigner.c, assigner.h, p600.c, p600.h]
2013-02-23 user interface overhaul / mapped more pots and switches
2013-02-23 tuner tweaks / now tuning filter offset
2013-02-25 adding glide / bugfixes
    [p600.c, scanner.c, synth.c]
2013-02-26 improved / fixed many things
    [assigner.c, dac.c, hardware_impl.h, p600.c, potmux.c, synth.c, synth.h, tuner.c]
2013-02-27 fix welcome message not showing
    [p600.c]
2013-03-02 trying to make the tuner more robust / CYCLE_WAIT fix
    [hardware_impl.h, tuner.c]
2013-03-02 DAC timing fixes (snappier VCA envelopes / trying to fix potential problems) Tuner broken because of this (probably because of the tuner itself)
    [p600.c, p600firmware.c, synth.c]
2013-03-02 tuner: scale error estimation fix / tweaks
    [tuner.c]
2013-03-06 teensy bootloader hack to allow self-programming
2013-03-07 yet another tuner rework, now only does offset tuning for each octave
    [p600.c, tuner.c, tuner.h]
2013-03-07 trying something for pot scan problems...
    [potmux.c]
2013-03-07 scanner & cv timing fixes
    [scanner.c, synth.c]
2013-03-07 tuner feedback fix / adjusted tuner VCA level / tuner emits sound for now (even in release mode)
    [tuner.c]
2013-03-08 tuner: rework using successive approximation algorithm (closer to what the Z80 does)
    [potmux.c, tuner.c, utils.c, utils.h]
2013-03-09 removing dac fastpath, regular path is as fast and less buggy!
    [dac.c, hardware.h, p600firmware.c, potmux.c, synth.c]
2013-03-09 timing fixes / important low level fix / test code
    [display.c, display.h, p600.c, p600firmware.c, potmux.c, tuner.c]
2013-03-10 smarter (faster) pot mux / chromatic/free* pitch option (using "6" button) / filter cutoff range & tracking fixes
    [p600.c, potmux.c, tuner.c, tuner.h]
2013-03-24 synth: timing fix for bulghur's P600
    [synth.c]
2013-03-24 storage starting to work for settings and presets / misc changes (programming a new firmware resets storage for now...)
    [adsr.c, adsr_lookups.h, assigner.c, display.c, p600.c, p600.h, storage.c, storage.h]
2013-04-07 utils: fix for mockup
    [utils.c, utils.h]
2013-04-07 high level code refactorings and fixes
    [adsr.c, p600.c]
2013-04-20 discarded some of the experimental changes / scanner improvements / (hopefully) proper fix for bulghur's PW noise bug
    [p600.c, potmux.c, scanner.c, synth.c, synth.h, tuner.c]
2013-04-20 working 6850 MIDI UART / misc fixes
    [hardware.h, p600.c, p600firmware.c, scanner.c, tuner.c, uart_6850.c]
2013-05-02 fixing mono modes envelope
    [p600.c]
2013-05-02 poly assigner rework: 7th pressed note is ignored / stealing oldest voice in release stage on new pressed note
    [assigner.c, assigner.h]
2013-05-02 trying to fix cold boot problems
    [p600firmware.c]
2013-05-02 display: add blinking for 7seg dot & tune led
2013-05-03 fixing displayed pot value precision
    [p600.c]
2013-05-03 much better pot change detection system / using it to avoid unnecessary bender and tuned CVs computations
    [p600.c, potmux.c, potmux.h]
2013-05-03 now using hardware interrupt for MIDI UART (needs an additional wire on the teensy from C4 to E4) / bender offset was a really stupid way to fix my misaligned pitchwheel / low level tweaks
    [p600.c, p600.h, p600firmware.c]
2013-05-03 UART interrupt should be level based
2013-05-03 an apptempt to fix "stuck" voices (closing the VCA to mute a voice is not enough it seems...)
    [p600.c]
2013-05-05 many fixes: "pulse off" CV value / proper way to silence a voice / fixed computeTunedCVs change detect opti
    [p600.c]
2013-05-05 possible PW noise fix: also update PW from int
    [p600.c]
2013-05-06 adding MIDI velocity support, with customizable amount going to VCA/VCF envs level
2013-05-07 big refactoring: unified way to store 'stepped' parameters (switches basically), nicer code, and full midi control of those
2013-05-07 VCA kick-start, to allow shorter minimum attack
    [p600.c, p600.h]
2013-05-08 storage: fix for settings storage
    [storage.c]
2013-05-08 lfo: two more shapes: saw and noise (digital, 2khz)
    [lfo.c, lfo.h, p600.c, storage.c]
2013-05-08 added working arpeggiator, up-down / assign / random, any mode can be held -- assigner changes & fixes
    [adsr.c, arp.c, arp.h, assigner.c, assigner.h, p600.c]
2013-05-09 arp: fixes for proper sustain/release handling
    [adsr.c, adsr.h, arp.c, assigner.c, assigner.h, p600.c]
2013-05-09 misc fixes: settings storage / manual mode 7seg display
    [hardware.h, p600.c]
2013-05-09 lfo: using a lfsr (linear feedback shift register) for the noise waveform, faster, and allows a bit of control on "tone"
    [arp.c, lfo.c, lfo.h, p600.c, utils.c, utils.h]
2013-05-09 midi: adding program change and bank number support (for preset number and switch between preset and manual)
2013-05-10 synth: relax/improve timing (cf tohk issue on github)
    [synth.c]
2013-05-10 digit buttons paging system / refactoring hit "to tape" for sound settings, "from tape" for misc settings. misc page has midi recv channel on "1", and bender calibration on "2"
2013-05-18 updater: fix MIDI not working sometimes
    [p600firmware.c]
2013-05-18 fix preset mode pot stepping
    [p600.c]
2013-05-18 preset system & importer fixes
    [import.c, p600.c]
2013-05-19 manual mode fix, in case the synth starts in preset mode
    [p600.c]
2013-05-19 code size optimisations where speed doesn't matter much
    [adsr.c, display.c, import.c, lfo.c, p600.c, storage.c, tuner.c, utils.c]
2013-05-19 fixing a potential low level bug
    [p600firmware.c]
2013-05-19 import: fix modheel range
    [import.c]
2013-05-19 potantial fix for poly voicing problems
    [p600.c]
2013-05-23 trying to improve VCF shortest attack too
    [p600.c]
2013-06-01 tuner: now tuning using the teensy, faster and preciser
2013-06-15 tuner: back to 8253 version, with tweaks from the teensy one
2013-06-29 uart: adding send
2013-06-30 assigner/arp: fixes / cleaner interations
    [arp.c, assigner.c]
2013-07-15 ui: now having 2 actions per button
2013-07-16 unison detune -- refactorings -- fixes
    [assigner.c, p600.c]
2013-07-16 all new parameters implemented -- adding MIDI send channel setting (not used for now) -- misc opti & fixes
    [import.c, lfo.c, lfo.h, p600.c, p600.h, storage.c, storage.h, ui.c]
2013-07-17 assigner fixes -- code speed fixes
    [assigner.c, assigner.h, p600.c, storage.c, ui.c]
2013-09-14 ui fixes -- lfo target fix -- new "octave" pitch mode
    [p600.c, p600.h, storage.c, storage.h, ui.c]
2013-09-14 manual mode now defaults to "octave" pitch
2013-09-14 typos & other comments fixes
    [adsr.c, lfo.c]
2013-09-14 increased tuner timeout -- revert to theoretical tuning before a new tuning attempt (may fix "hot" tuning problems)
    [tuner.c]
2013-09-14 proper envs snappiness fix -- assigner fixes & optimisations -- better modulation delay algorithm
    [assigner.c, assigner.h, p600.c, potmux.c]
2013-09-14 separated MIDI and main code -- manual mode settings are now stored -- new command to reset to a basic saw preset (from tape + 7)
    [midi.c, midi.h, p600.c, storage.c, storage.h, ui.c]
2013-10-26 sync with overcycler: merging changes (fixes & speedups)
    [adsr.c, assigner.c, lfo.c, utils.c, utils.h]
2013-10-26 sync with overcycler: adding MIDI pitch bend / modwheel support -- less stuff in synth_update()
2013-10-26 this fixes post-beta1 "ghost" tones on at least one p600
    [synth.c]
2013-10-26 adding new ui sheet
    [new_ui.ods]
2013-10-30 fix for midi in notes sometimes dropped
    [uart_6850.c]
2014-03-01 adsr/utils: fixing broken interpolation
    [adsr.c, utils.c]
2014-03-17 ui: extended params now display value when selected -- misc fixes
    [synth.c, ui.c, ui.h]
2014-03-17 assigner: simpler/safer way to handle MIDI out for notes fixes stability problems with unison
    [arp.c, assigner.c, assigner.h, midi.c, synth.c, synth.h]
2014-03-17 bender: immediate update on calibration
2014-03-17 ui: fix manual mode unison storage
    [ui.c]
2014-03-17 assigner: this causes more problems than it fixes
    [assigner.c]
2014-04-07 doc: affing MIDI CC map
    [midi_cc_map.ods]
2014-04-20 assigner: legato fixes -- storage: proper error handling, manual preset fix
    [arp.c, assigner.c, assigner.h, midi.c, storage.c, synth.c]
2014-04-26 doc: CC map tidying & fixes
    [midi_cc_map.ods]
2014-05-24 sh: 32bits fastpath opti / one more wait state in fastpath may fix some oscB tuning issues
    [sh.c]
2014-05-24 synth: mod delay on release stage
2014-05-24 ui: save manual preset when switching to preset mode
2014-05-25 doc: english user manual update for 2.0
    [midi_cc_map.ods, new_ui.ods]
2014-05-26 ui: don't quantize "data pot" continuous params
    Continuous parameters assigned to the data pot were not adjustable in
    increments smaller than CHANGE_DETECT_THRESHOLD even though the LCD
    misleadingly suggested they were changing (they weren’t).
2014-05-29 ui: prevent slowdown caused by unwanted updates (side effect of last pull)
    [synth.c, ui.c, ui.h]
2014-06-08 enabling filter ext cv input
2014-08-22 sh: trying to shorten the fastpath timings again
    [sh.c]
2014-08-22 fixing problems with pitch & mod wheels resolution
    [synth.c]
2014-08-29 sh: fix for Osc B being out of tune on some P600
    [p600firmware.c, sh.c]
2014-08-31 silencing deassigned voices by resetting the envs
    [adsr.c, adsr.h, synth.c]
2014-09-06 assigner: a full assigner reset (eg: switching unison on then off) resets to voice #0
    [assigner.c]
2014-09-15 sh: this wait state is mandatory for some P600s, else tuning can go wrong (cf mc8's issue on gearslutz)
    [sh.c]
2014-09-19 Fix issue #35, arpeggiator notes in wrong order
    [arp.c]
2014-09-25 Fix issue #34, set velocity from internal keyboard to mid range = 64
    * Applies both to notes played on the keyboard and from the arpeggiator.
    * We use 32768U, as UINT16_MAX>>9 yields 63 instead of 64, and there's
    no other nice symbolic way to say 'half of UINT16_MAX+1'.
    [arp.c, synth.c]
2014-09-25 Part of fix for issue #33, added MIDI reception of hold pedal
    * Move VCA env fast/slow parameter to end of stepped parameter list
    to make room for hold pedal CC (64).
    * Just a stub for the actual hold function for now.
    [assigner.c, assigner.h, midi.c, storage.h]
2014-09-25 Rest of fix for issue #33, implemented hold pedal in assigner
    [assigner.c]
2014-09-25 Added 'gated' property to assigner
    * This way we can avoid sending gate off to voices that are already gated
    off.
    - Shouldn't really make a difference, but seems conceptually more sound.
    [assigner.c]
2014-09-25 Fix issue #38, max velocity spike when releasing keys
    * If >= 8 keys are pressed, there will be a max velocity spike when a key
    is released and the assigner attempts to reassign with the intent of
    finding a key that is presed but which no voices are playing, and
    assign it.
    * The reason is that in the loop after the block in which restoredNote
    is set, if there is no voice corresponding to the key just released
    (such as when releasing #1 of 8 keys pressed; the voice corresponding
    to the #1 key will have been stolen so that there is no voice playing it),
    the loop attempting to gate off the voice or find an oldVel for the
    new allocation, will terminate without oldVel being change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
    [assigner.c]
2014-09-25 When restoring note, set legato also when not in mono mode
    * This is really also part of the fix for issue #38, as restored
    notes should not be retriggered but just be gated on with legato.
    [assigner.c]
2014-10-04 Added deadband for pitch wheel
2014-10-04 Add guard at top and bottom of range when deadbanding
    * This is important to get true intervals for the pitch wheel, because
    the analog voltage from the wheel as seen by the ADC is not the
    whole available range, leading to the resulting output from the ADC
    not to cover the whole 0..65535 range.
2014-10-04 Precalculate band calibration scale factors
    * Also clean up UI call to update bender when calibration changed
2014-10-05 ui: fix parameter initial value display
    [ui.c]
2014-10-05 ui: basic patch is now FROM TAPE + 0 -- fixes issue #41 FROM TAPE + 7 is an invalid combination due to how the membrane keypad works
    [ui.c]
2014-10-05 sh: tentative fix for yet another tuning issue cf Mickey B comments on my blog
    [tuner.c]
2014-10-06 midi: fix issue #46
    [midi.c, midi.h, synth.c]
2014-10-07 dac: inlining there causes DAC addressing problems...
    [dac.c]
2014-10-07 lfo: avoid 32bit math and division (huge opti!)
    [lfo.c]
2014-10-12 storage: fix side effects of spAmpEnvSlow relocation
    [storage.c]
2014-10-12 adding 2 track step sequencer - press SEQx to activate the sequencer, it will wait for you to play a note to start playing. - press SEQx again to force start. - press RECORD while the sequencer is ac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
2015-01-24 fixing wrong bender intervals (issue #53)
    [ui.c]
2015-01-24 fix minor record button logic problem
    [ui.c]
2015-01-24 fix issues #42 #51
    [arp.c]
2015-01-24 seq: changes suggested by ricard (see below) -- other minor fixes - Pressing SEQx immediately starts playing the respective sequence. Pressing it (them) again stops it. - To record, first press RECOR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
    [synth.c, ui.c, ui.h]
2015-01-24 adding scaling adjustment mode (see below) (issue #55) - Enabled by powering the synth with "TP301 SCALE" shorted. - Will alternatively display the current oscillator/filter (A1..A6,B1..B6,F1..F6) an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
    [synth.c, tuner.c, tuner.h]
2015-02-08 seq/arp: reset to first note when receiving MIDI start
    [arp.c, seq.c, seq.h, synth.c]
2015-02-08 arp: hold logic sanitizing (fix issues #57 #58)
    [arp.c, arp.h, synth.c]
2015-02-08 seq: pressing 0 while recording a track clears it
2015-02-18 scanner: fix for some occasional UART overruns
    [scanner.c]
2015-02-21 fixing wrong OscA pitch when polymod routes OscB to FreqA.
    [synth.c]
2015-02-22 adding option to limit VCF Fc to 22Khz to avoid sound harshness due to strange filter behavior in the ultrasound range
    [storage.c, storage.h, synth.c, ui.c]
2015-03-02 doc: adding draft spec for SYSEX patch dump format
    [sysex_format.ods]
2015-03-02 doc: sysex_format fix (missing patch number)
    [sysex_format.ods]
2015-03-07 ui: shortening the parameters text for improved editing immediacy
    [ui.c]
2015-03-07 ui: more text shortening
    [ui.c]
2015-03-07 limit RAM usage -- storage_eport fix
    [storage.c, synth.h]
2015-03-07 documentation: sysex_format fixes and additions
    [sysex_format.ods]
2015-03-15 These flags now cause problems and don't lower code size
    [utils.h]
2015-03-15 storage: wrong version -- buffer overflow fix
    [storage.c]
2015-03-15 updater fixes - was unable to flash pages after offset 65536 - moving to -O2 caused the crc function to not be inlined, making the updater overwrite it and crash
    [p600firmware.c]
2015-04-12 Cleanup and bug fixes
    * Replace seq.foo[track] with tp->foo . Saves code area.
    * Fix bug where doing undo on sequence with notes held erases
    whole sequence rather than just last event.
    * Split seq_inputNote into two functions.
    * Use // for all comments
    [seq.c]
2015-04-12 Avoid entering duplicate notes in chords
    [seq.c]
2015-04-12 Fix problem of missing first note in sequence when both started together
    * This is actually quite intricate, as the reason for the problem is that
    we restart seq.counter ever time we start a sequence, meaning that
    starting the second sequence will in practice cause the first step
    of the first sequence to be cut short.
    * So change to only resetting seq.counter on first track started.
    * That in turn means that the first step of the second sequence must
    potentially be started from the mode set call, if the second sequence
    is started just after the first, otherwise the first step of the
    second sequence won't be played until the second step of the first
    sequence.
    * Conversely, if th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
    [seq.c]
2015-04-12 Don't print 'clear' when erasing sequencer data
    * It's quite clearly shown in the display anyway as the counter goes to 0.
2015-04-12 Fix last played note(s) hanging when seq is reset
    [seq.c]
2015-04-12 Fix unexpected clobber of R16 in storage_write
    * Contrary to what can be gleaned from the code, R16 appears to be clobbered
    somewhere in storage_write, possibly by bHack_call_SPM in the bootloader.
    [p600firmware.c]
2015-04-12 Don't do clock reset when arp button pressed if sequencer running
    [arp.c]
2015-04-12 Don't always reset beat when pressing SEQ1, 2 or ARP
    * Only reset beat if using internal sync and nothing else running,
    or when MIDI START received.
    [arp.c, arp.h, seq.c, seq.h, synth.c]
2015-04-24 fix wrong tuning for old presets
    [storage.c]
2015-04-26 Fix warning on non DEBUG build
    [midi.c]
2015-04-30 Avoid noise at audio output at start of TUNE (fixes issue #67)
    * When TUNE pressed, add 150 ms delay in order to give final volume VCA
    a chance to close (the CV is connected via an RC network with a time
    constant of about 35 ms) completely before tuning starts, in order to
    avoid passing the tuning signals to the audio output at the start of tuning.
    * Empirically on the P600 used for testing this, a 50 ms delay is too short,
    100 ms is ok, so set it to 150 ms to allow for component tolerances; also
    the autotune routine takes quite a while anyway so an extra 50 ms or so
    will not be noticable so we might as well be on the safe side.
    [tuner.c]
2015-04-30 Fix problem with thumping when voices triggered first time (fixes issue #68)
    * Since computeTunedCVs only runs in its entirety when the corresponding
    voices are assigned, after starting up the filter CV is very far (for
    instance, 0V) from where it will be once the voice is triggered.
    One some synths with 3372 chips with fairly larger filter CV feedthrough
    this causes an annoying thump in the audio the first time a voice is
    triggered after power on. Avoid this by running computing the filter
    (and oscillators, as a bonus) CV (using a default note value = bottom
    note on keyboard) when the synth starts up.
    [synth.c]
2015-04-30 Fix hung notes after being held while ARP enabled (fixes issue #64)
    [arp.c, assigner.c, assigner.h]
2015-04-30 For all notes off, loop over voices rather than notes
    * Because it makes for a shorter loop.
    [assigner.c]
2015-04-30 Only release notes whose keys are down when enabling arp
    * This means that when for instance playing the sequencer or MIDI notes
    at the same time, only the notes played by the keyboard are released;
    in particular it avoids chopping of sequencer notes that are playing.
    The downside is that it doesn't really work too well when the notes
    are held by the hold pedal, as then they won't be released since the
    corresponding keys are no longer down.
    [arp.c, assigner.c, assigner.h, scanner.c, scanner.h]
2015-04-30 When doing all keys off, ungate all keyboard-triggered voices
    * This fixes the problem of held voices remaining held after arp started,
    while at the same time allowing MIDI triggered voices to be held.
    * There is still one slightly confusing and esoteric condition: If
    notes triggered via are held using the P600 sustain pedal, when
    arp is enabled, the notes will still be held, as they were not triggered
    from the keyboard, and since the pedal now functions as arp latch,
    the notes will remain held until arp is exited and the pedal subsequently
    released (or the voice allocator robs the held voices, which will happen
    sooner or later as they have lower priority than the actually play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
    [arp.c, assigner.c, assigner.h, midi.c, seq.c, synth.c]
2015-04-30 Conditionally avoid note status clear in voicesDone
    * Fixes problems in case of contact bounce in the Unison switch. There is
    already debouncing which fixes short-term bounce in momentary switches, but
    slide switches such as Unison can suffer from bounce all along their
    travel, which cannot successfully be handled with ordinary debouncing,
    or the switch response will appear sluggish. Hence we need to see to
    that the note state is not changed as we go into unison mode, or else
    an attempted Chord Memory assignement will become Unison if the Unison
    switch has contact bounce.
    [assigner.c]
2015-04-30 Replace long if statement with switch
    [ui.c]
2015-04-30 First time a misc parameter is selected only displays it (issue #43)
    * In order to actually change the value, press the corresponding numeric
    key again.
    * As soon as pbFromTape is pressed or released, or another parameter
    selected, revert to "display" mode.
    [ui.c, ui.h]
2015-04-30 Require two presses for misc functions that 'do something'
    * In keeping in line with the misc functions which only actually change
    the corresponding parameter when the appropriate numeric button is
    pressed a second time, require two presses for bender cal, midi
    patch dump and init patch. Especially the last of these is annoying
    if accedentally pressed, loosing the current edit.
2015-04-30 Allow transposition by double-clicking FROM TAPE (issue #69)
    * FROM TAPE flashes while transposition is enabled.
    [synth.c, ui.c, ui.h]
2015-04-30 When misc settings entered, clear double click toggle
    * This avoids confusing the user who might inadvertently press FROM TAPE
    twice within the double click interval while fiddling with the misc
    parameters.
    [ui.c]
2015-04-30 Use single press to exit double click mode
    * This makes it easier to get out of double click mode, especially if it has
    been entered by mistake, as the natural behavior when the From Tape LED
    starts flashing would be to simply press the button.
    [ui.c]
2015-05-02 Reduce range of pitch retune For greater accuracy
2015-05-02 Change preset.perNoteTuning to power-of-two units Uses all 16-bits for greater tuning precision, and avoids divides in performance sensitive tuner_computeCVFromNote() code
    [midi.c, storage.c, storage.h, synth.c, tuner.c]
2015-05-02 Fix retune-mode UI after rebasing from master
    [ui.c]
2015-05-02 Blink Tuning LED when in note-retune mode
2015-05-02 Ugh, another CLRF problem, renormalize for sanity
    [synth.c]
2015-05-02 Avoid overflows on new lower-range tuning units
    [tuner.c]
2015-05-02 do led changes in refreshSevenSeg prevents led state overwriting
    [synth.c, ui.c]
2015-05-14 doc: fixes / clarifications to sysex_format (issue #59)
    [sysex_format.ods]
2015-05-14 doc: more sysex_format fixes
    [sysex_format.ods]
2015-05-15 tuner: fixing broken note interpolation
    [tuner.c]
2015-08-05 Revert "fixing wrong OscA pitch when polymod routes OscB to FreqA."
    This reverts commit e5d5919407561c917eab34851760dedf4e052ad2.
    [synth.c]
2015-09-05 ui: shortening more text
    [synth.c, ui.c]
2021-11-14 Rearrangement of documentation
    Separattion of User Manaual (dependent on version) and Teensy
    Modification (independent from version). Added compilaton and package
    information for Linux.
2021-11-14 PWM bug fix and widening of bender deadband
    Note: two fixes/changes from J. Sepulva
    [synth.c]
2021-11-14 Fix for post-tuner vol issue
    Fix taken from J. Sepulveda's V2.26B
    [synth.c, synth.h, ui.c]
2021-11-16 Robustness of editing setting
    Invalid MIDI send and receive channel values are change to valid value
    upon load. Invalid value make the UI crash (and potentially create other
    problems). Further changes: commenting and removing Seq/Arp clock from
    present defaults.
    [storage.c, synth.c, ui.c]
2021-11-27 Envelope routing, LFO sync, and optimization
    Envelope routing was introduced in synth_update() and LFO sync was
    introduced in synth_timerInterrupt()
    In addition: optimization for bender changes: function
    addWheelToTunedCVs() now uses precalculated voltages, so faster. An
    compute BenderCVs() now uses precalulated tunde bender CVs (max
    bending), calculated in function computeTunedBenderCVs(). Now there are
    no longer performance issues with incoing MIDI bend events, which were
    particularly audible in seq/arp slow downs.
    [synth.c]
2021-11-28 Minor correction in LFO sync
    ... and removing commenting out of single voice tuning routine
    [synth.c]
2021-11-29 Additive internal and MIDI bending (see issue #2)
    Internal bend and MIDI are now stored internally and the sum of the two
    is applied. Note that in total this delivers twice the bend range set
    for the internal bender.
    [midi.c, synth.c, synth.h, utils.c, utils.h]
2021-11-29 Wrong mode switch in seq record mode fixed (issue #1)
    [ui.c]
2021-11-30 Add basic Teensy++ 2.0 documentation
2021-12-02 Local mode on/off, new random arp
    This includes the new local on/off mode, the modified random mode and
    two fixes concerning menu logic bugs
    [arp.c, assigner.c, assigner.h, seq.c, storage.c, storage.h, synth.c, synth.h]
2021-12-02 Fix for glitchy mod wheel action
    [potmux.c]
2021-12-06 Pulse Sync Bug - patch parameter
    The new 888 patch parameter switches the Pulse Width Bleed bug on or
    off. On ist required for backward compatibility and will be the default
    when patches from earlier versions are loaded.
    [storage.c, storage.h, synth.c, ui.c]
2021-12-06 Chaning up/down pattern and fixing a crash bug
    The up/down pattern now doesn not play the bottom an top notes twice.
    The arp has partially been rewritten with this code change
    [arp.c]
2021-12-11 Change the base note of the keyboard
    Issue #6
    [scanner.h]
2021-12-11 Sending of porgam change by MIDI
    Issue #22
    [midi.c, midi.h, ui.c]
2021-12-11 Pedal MIDI event and smooth mod wheel
2021-12-14 New features soft bend, detune tarcking; unison fixing
    The setting "spread" is not a patch parameter (777). The load of the
    default patch is now on the Preset button and the local on/off has moved
    from "7" to "0".
    Various fixes in the unison pedal latch and related assigner logic
    (missing key off event). Also: on pedal press the played chord is now
    retriggered. The pedal press is not sent during unison mode. An the
    incoming MIDI switch to unison is only carried out if not in unison
    mode.
    A new parameter detune tracking (888).
    In order to test softer mod wheels the mod wheel range contains now 8
    setting (4 soft ones and 4 original ones).
    [assigner.c, assigner.h, midi.c, storage.c, storage.h, synth.c, synth.h, ui.c]
2021-12-19 Update documenation on settings and patch menu
    - New spread patch parameter
    - changes in the settings of default patch and local off
    - Settings functions of Preset, Tune and Record buttons
2021-12-21 Documentation of storage on the Teensy board
    Location and content of pages, maximum code size
2021-12-22 Introduction of "pick-me-up" pot behaviour in preset panel mode
    As described in isse #26: the remedy for the situation in which the pots
    (and switches) don't show the current active panel parameters is a
    pick-me-up mode in which the user needs to turn a pot until is
    corresponds to the active value before it takes effect (e.g. the uer
    picks up the value). In order to give feedback to the user the disply
    show whether the pot value is below or above the current active control
    value and then switches to numeric display once picked up. The pot
    status is reset if a patch is loaded or a MIDI patch SysEs is loaded
    into active controls because these are the situations where the panel
    doesn't show the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
    [display.c, potmux.c, potmux.h, storage.c, storage.h, synth.c, tuner.c]
2021-12-22 Minor correction in pick-me-up mode, noise / ext voltage support
    [display.h, storage.h, synth.c, ui.c]
2021-12-22 Reverse change in tuner
    [tuner.c]
2021-12-29 Minor correction in entering unison mode
    [assigner.c]
2021-12-29 Added function to switch off LED blinking w/o switching off LED
2021-12-29 Various changes (MIDI control of seq/arp, MIDI extensions, MIDI mgmt mode(
    Related to issues #15, #16, #26, #39, #48, #49
    [import.c, midi.c, scanner.c, storage.c, synth.c, synth.h, ui.h]
2021-12-29 Auxiliary function in preparation of linear detune
    Related to issue #42
    [tuner.c, tuner.h]
2021-12-31 Fixing wrong Record LED blinking for arp hold
    [synth.c, ui.c]
2021-12-31 Fix for fading master volume (issue #51)
    Now there is an internal variable which is changed by either a MVol pot
    movement (see function synth_update()) or external MIDI CC (see call to
    function synth_VolEvent()). Either one overrides the other. The internal
    variable is used to continuously update the volume voltage.
    [synth.c]
2021-12-31 Fix for MIDI CC 122 (issue #15)
    [midi.c]
2021-12-31 Fix for MIDI CC 123 (issue #15)
    [midi.c]
2021-12-31 Fix for arp/seq speed always zero on startup, never recalled
    [storage.c, synth.c, ui.c]
2022-01-01 Another fix of MIDI CC 122 (issue #15)
    [ui.c]
2022-01-01 Potmux change detect mod and UI logic correction
    In Potmux the pot value is not forced to the maximum, when a certain
    threshold is reached. It is unlcear whether that is a sound solution, so
    it's a test for solving the issue #52 when the filter sustain maximum is
    notably smaller than the peak of the attack/decay curve.
    In addition to that there are the following changes:
    - resetting of MIDI pitch bend (included in bender calibration)
    - Fixes for the UI LED logic
    - Small changes (nice display messages, no prog change MIDI when storing
    a patch)
    [potmux.c, synth.c, ui.c]
2022-01-05 Correction making old patches compatible (PW sync bug)
    Making sure that for old patches (V<8) the bug is "on" like in the
    versions up to 2.1RC3
    [storage.c]
2022-01-11 Smoother LFO Amount action
    Some commenting. Main change: smoother LFO amount action (issue #63)
    [synth.c]
2022-01-11 New envelope shapes (SSM / P5 rev1/2 inspired)
    See issue #64.
    Now the new linear/hybrid shapes replaces the old linear shape. The
    phase lookup had to be rescaled for this in order to make old patches
    with linear shape roughly compatibel. Old patches are automatically
    rescaled. The head room for decay and release pots has strongly
    increased as a result.
    [adsr.c, adsr.h, adsr_lookups.h, import.c, storage.c, storage.h, ui.c]
2022-01-11 New dynamic potmux state to have fast action on non-priority pots
    Now non-priority pots are temporarily lifted to fast rotation when
    touched. This makes pots very respsonsive in fast movements which were
    glitchy before, esp.: LFO Amount, PWM A&B, Polymod Env (in combination
    with Filter Sustain). Resolution of Freq A & B has also been increased.
    Furthermore, lfoUpdates are now executed in every synth_update() cycle.
    The overall result is that all dials are now fully responsive, with only
    glitches in very fast movements on dials when then directy and strongly
    affect the oscillator frequency.
    [potmux.c, potmux.h, synth.c]
2022-01-11 Docu updates (faq plus some corrections)
    [p600firmware.c]
2022-01-13 Rearrangement of the patch parameter menu
    Complete rearrangement, issue #27
    [ui.c]
2022-01-13 Removeal of LFO speed range, mod wheel range and introduction of VCA vib target
    Removal of mod wheel range: issue #75
    Removal of LFO speed range: issue #73
    Introduction of vib target VCA (and parameter): issue #61
    [lfo.c, lfo.h, synth.c]
2022-01-13 Removal of LFO Shift and mod wheel range from parameters
    Removal affects:
    - internal parameter listing
    - storage
    - MIDI CC
    - import of Z80 patches
    - functions of loading legacy patches
    Aslo: reprogrammed functions to derive values ranges from MIDI CC 7 bit
    input for stepped parameters (changed from using bit size to using
    number of values)
2022-01-15 Hotfix for alpha 11 fixing zero envelope times
    The alpha 11 suffers from a bug that makes al enevelope times zero when
    loading patches from memory or MIDI SysEx. This hotfix contains the fix
    for that problem only
    [storage.c]
2022-01-15 Corrections to the prog change by MIDI or data pot (related issue #72))
    Reset of the preset change dot after prog change
    [midi.c, ui.c]
2022-01-15 Added missing straoge of external voltage (related #16)
    [storage.c]
2022-01-15 Increased frequency of PMod OSC B voltage (see #71)
2022-01-15 Another small change to the param menu (see #27)
    Swapped filter enveloped and 2nd envelope. Renaming spread --> vintage
    [ui.c]
2022-01-15 Redesigned vintage effect (formerly: spread) (see #41)
    There is now a randomization for the different parameters per voice
    (pitch a, patch b, cutoff, adr times for filter and amp envelopes). The
    most immediate effect of this is that osc A and B are detuned within
    each voice.
    [synth.c]
2022-01-15 Fixed the bug in issue #53 (storage of spread/vintage param)
    plus a small bug through which menu parameter changes are lost in the
    process of storage (see ui.c change in this commit)
    [storage.c, ui.c]
2022-01-16 Further rescaling of LFO amount (was too soft), see #63
    Also included: bugs in vintage/spread formular for pitch and cutoff
    [storage.c, synth.c]
2022-01-16 Fix for wrong import of old patches (issue #77)
    This fixes the failed scaling of LFO frequency
    [storage.c]
2022-01-16 Fixes to data pot (#79.3) selecting patch including add. protection (#81))
    Selecting patches using the data pot now requires holding From Tape
    down. The question is if the user would rather like to have the other
    free to try the patch?
    [ui.c]
2022-01-16 Fixing missing dot in display (#79.4) and tweak for envelope tail (#64)
    [synth.c]
2022-01-18 Fixing arp u/p buggy behaviour (#82)
    Changed the u/p pattern back to the old logic, but kept the 12321
    variant
    [arp.c]
2022-01-18 Pick-me-up mode for switches (#62), reduction of stores (#83) and new freq granularity (#87)
    -First version of pick-me-up logic for switches (deliberate choice of
    symbol: "[]".
    - MANUAL PAGE is not stored anymore when a new menu parameter is
    selected but if it is selected AND changed
    - New choices for frequency pot granulairty, with different choices for
    A and B, including a new display feature showing semitones or octaves
2022-01-18 Rescaling of vibrato amount
    [storage.c, synth.c]
2022-01-19 Reversal of the pick-me-up mode for switches (#62)
    Too clumsy and heavy and the tracking button is unreliable for the
    purpose.
    [synth.c, ui.c, ui.h]
2022-01-19 Rescaling of vib->VCA modulation (#61) and rerouting LFO-->VCA to Vol A/B instead of voice preamp
    The rerouting of LFO->VCA modulation from coive pre-amp to the two
    volumes A and B per voice is experimental. It could prepare the
    separation of the VCA target choice from the oscillator target choice
    parameter, so that one can achieve in the next step:
    - adjust the LFO->VCA level (relative to the other targets)
    - apply the oscillator choice AB, A, B also to VCA modulation
    - plus idea: inroduce a new oscillator choice: A-B (inverted polarity of
    oscillator
    [synth.c]
2022-01-24 Optimization for high frequency pot pick-up (#84), fix #89
    [lfo.c, lfo.h, potmux.c, potmux.h, sh.c, ui.h]
2022-01-24 Further optimization plus panel switch GliGli/SCI (#74), fixes
    Panel switch (#74):
    - setting change on From Tape + 6
    - swap of menu parameters Glide and Drive
    Optimization of cycles
    Repair of glide bug (#93)
    Making the fine tune pot softer in the middle (soft "deadband") (#85)
    [adsr_lookups.h, storage.c, storage.h, synth.c, synth.h, ui.c]
2022-01-25 Various fixes and reversal of PW pot scaling
    The reversal of pot scaling is in preparation of a survey of instrument
    specific values so that a good universally acceptable solution can be
    found.
    [lfo.c, storage.c, synth.c, ui.c]
2022-01-27 Removal of assigner mode "multi" (#100) and fix for display scroll bug
    [assigner.c, ui.c]
2022-01-27 Fix for u/p arp latch bug (#101)
    [arp.c]
2022-01-27 Another fix for patch compatibility (#77) plus minor fixes
    [potmux.c, storage.c, synth.c]
2022-02-01 Fix of missing de-latching in arp (#101)
    In fact, the assign and random arp have partially be reverted to the
    V2.1RC3 variant, but with a more robust solution for the randomness
    without multiple repeated notes.
    [arp.c]
2022-02-01 Further performance fine tuning (#84) and UI fixes (#103)
    [midi.c, potmux.c, potmux.h, storage.c, synth.c, ui.c, ui.h]
2022-02-01 Fix of missing mod wheel action (#107)
    [potmux.c, potmux.h, synth.c]
2022-02-03 Fix for analog clock in (#109) and new reduced mod wheel (#110)
    Tape in (clock) is now read in the 2kHz cycle and not in the 500Hz
    cycle.
    Note: somehow the error that was observed is a hint that not all cycles
    are properly completed (already in v2.1RC3). This requires further
    examination. But the fix for clock works anyway.
    The mod wheel ist softer no with a lower maximum value. For target
    vibration->VCA ist is the same as before (VCA is a much weaker
    modulation effect).
    [clock.c, synth.c]
2022-02-04 Reintroduction of mod wheel range parameter (#110)
    ... and some changes to DAC cycle wait times for static voltages. I
    discovered that it also affected non-time-critical functions such as
    tuning. Instead, the fast-path could be used for the static voltages in
    order to save time during the main cycle. But: should be kept for the
    being to see if it affects the glitchy and strange behaviour reported
    recently.
    [sh.c, storage.c, storage.h, synth.c, ui.c]
2022-02-10 mod wheel range parameter refinement
2022-02-27 Performance improvements (for #67) and minor fixes (#111 and #112)
    [potmux.c, potmux.h, storage.c, synth.c]
2022-03-09 Flipping order of LFO shape names (top/bottom) #116
    [ui.c]
2022-03-12 Fix for bug #134
    After selectin a menu parameter the potmux must be reset completely
    (also the focus status of all pots)--> ui_setNoActivePot(1) ... with
    parameter 1 (not 0)
    [synth.c, ui.c]
2022-03-16 Fix related to #134
    [ui.c]
2022-03-24 Fix of pick-up issue #133
    [potmux.c, synth.c]
2022-06-15 Fix for #151 pisplay issues in patch mgmt mode
    With these changes the following things are corrected:
    - The "patch modified dot" is no longer shown in patch management mode
    - After dumping the display correctly goes blank (showed parts of the
    last selection before)
    - After dump the dumped patch in not loaded. For this a non-load, check
    function was needed.
    [midi.c, midi.h, storage.c, storage.h, synth.c, ui.c]
2022-06-15 Fix for #147, #148 and #149 - MIDI CC compatibility
    This change undoes the reuse of MIDI CC numbers, in particular using the
    former CC LFO Range for new LFO Sync. This is to maximize compatibility
    with MIDI CC based tools. The same change was made to SysEx parameter
    order.
    [storage.c, storage.h]
2022-06-15 Fix for #145: modulation delay glitch on new notes
    [synth.c]
2022-06-19 Vibrato target VCO A or VCO B only (#161)
    [synth.c, ui.c]
2022-06-19 Bugfix on program change MIDI CC when the program does not exist
    [midi.c]
2022-06-20 Correction of add. MIDI CC documentation
    [midi.c]
2022-07-14 Rescale External Filter Voltage Parameter (#177)
2022-07-16 Misc fix of paraneters in Z80 patch import
    [import.c]
2022-07-16 Minor fix of patch load
    [storage.c]
2022-07-16 Fix for the fix of #177
    [synth.c]
2022-07-16 Major fix: harmonic pitch shift (#70)
    This is now a major improvement compared to older GliGli versions:
    tuning is taken into account for LFO pitch shifts on A & B and Poly-Mod
    pitch shifts on A.
    [synth.c]
2022-07-25 Fix for mod delay glitches (#180)
    The parameter value modulation delay is now cut off below about 20, i.e.
    not delay below that and jump to the delay value corresponding to 20.
    The reason is that the corresponding time frame below 20 is too short
    for the update cycle of the Prophet 600. That produced glitches. See
    also mod delay reset issue #145.
    [synth.c]
2022-07-26 Fix for wrong note in random arp (#183)
    [arp.c]
2022-09-19 Wrong vib for <v2022 patches (#192)
    There was a factor (division) of 4 missing: this was implemented in the
    v2.* (double bit shift >>2) but no longer in the v2022 version. In the
    patch conversion the factor was missing. Also, there was a small bug in
    relation to the DEADBAND, which affect the LFO and VIB amount conversion
    (although this was probably not noticable). It is corrected now.
    [storage.c, synth.h]
2022-09-26 Correction f mod wheel range import (#198)
    [storage.c]
2022-10-17 Fix infinite loop during linking on ARM
2025-11-17 now using external 24LC512 I²C EEPROM for storage, removed bootloader hack, removed firmware upgrade (reflashing the teensy thru USB won't erase the patches)
    [p600firmware.c, synth.h]
2026-04-13 Adding teensy programmer ready HEX file (issue #119)
