gligli/p600fw/(notices)

Notices in the files:
common/map_to_7segment.h:
modify it under the terms of the GNU General Public License as
published by the Free Software Foundation; either version 2 of
the License, or (at your option) any later version.
